apku04/sdr-doomsday-radio/hardware/README.md

# KiCad boards in this folder

Reference only. The owner changed the design on 2026-10-26: the front panel is hand-wired (no panel PCB) and the owner designs the HAT. These scripted KiCad boards (ERC/DRC clean) are kept for reference.
