apku04/sdr-doomsday-radio/hardware/hat/out/fab/sdr-hat-bottom.png

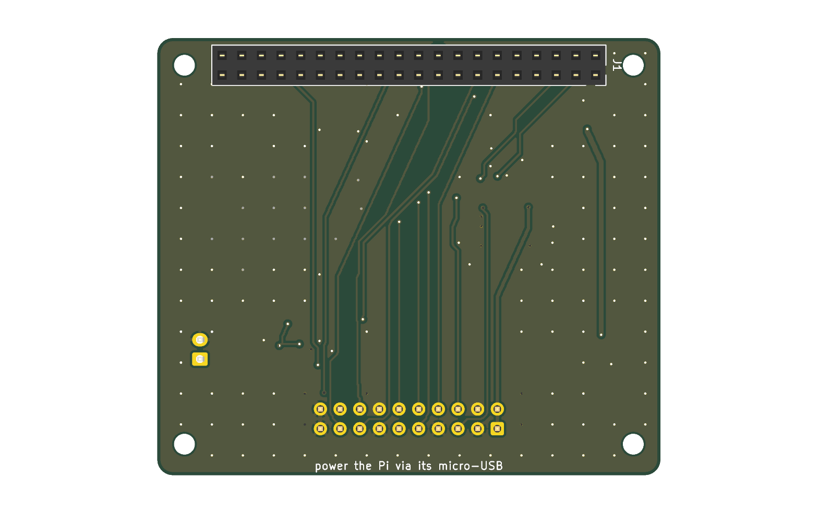
hardware/hat/out/fab/sdr-hat-bottom.png
