apku04/sdr-doomsday-radio/hardware/hat/out/fab/sdr-hat-top.png

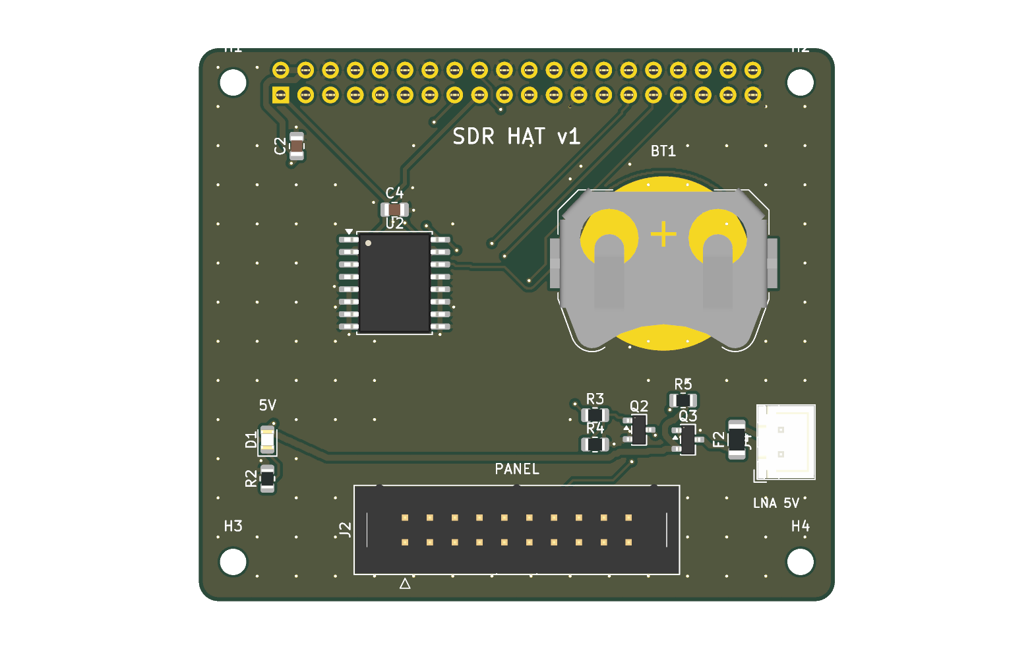
hardware/hat/out/fab/sdr-hat-top.png
