apku04/sdr-doomsday-radio/hardware/panel/out/fab/sdr-panel-bottom.png

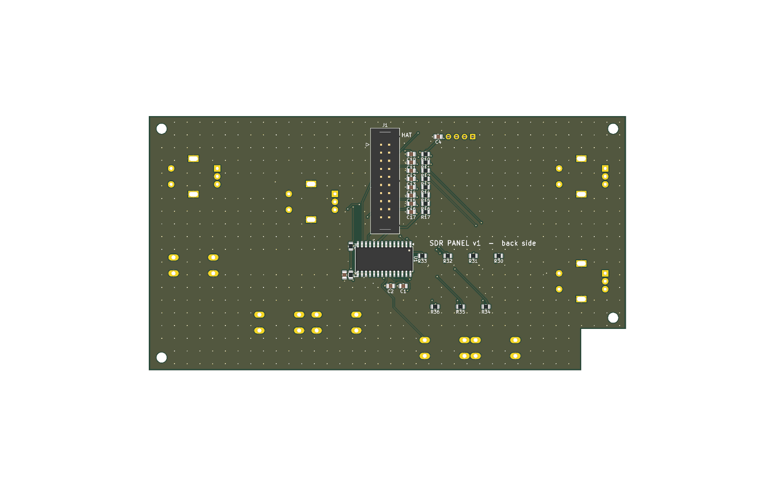
hardware/panel/out/fab/sdr-panel-bottom.png
