apku04/sdr-doomsday-radio/hardware/panel/out/fab/sdr-panel-top.png

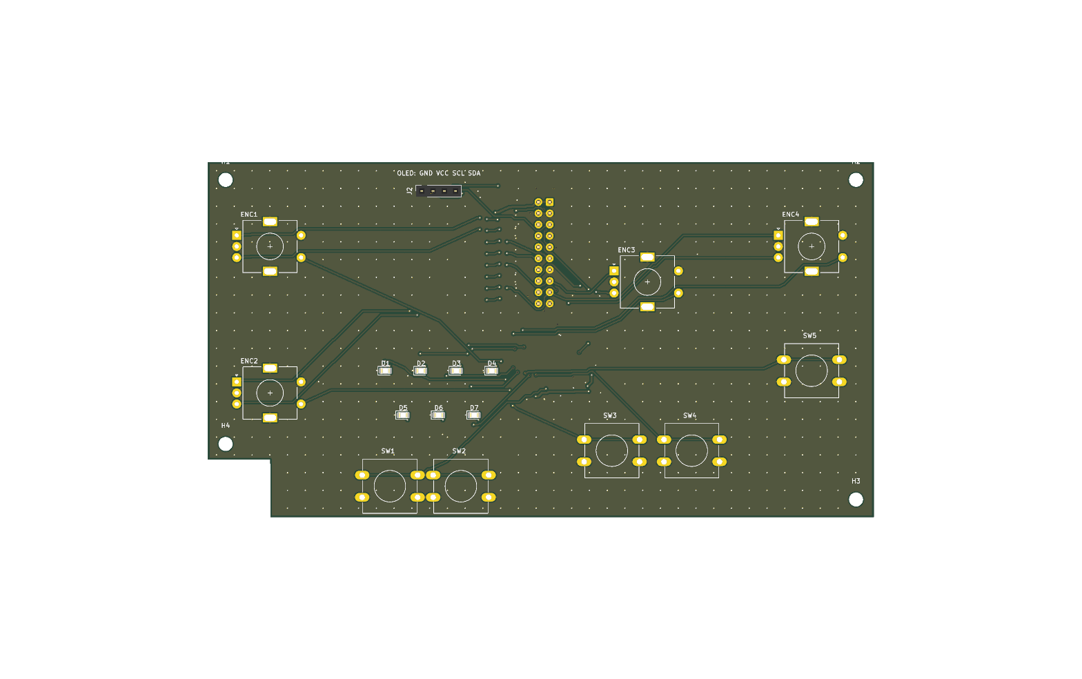
hardware/panel/out/fab/sdr-panel-top.png
