apku04/sdr-doomsday-radio/mechanical/out/preview_box_back.png

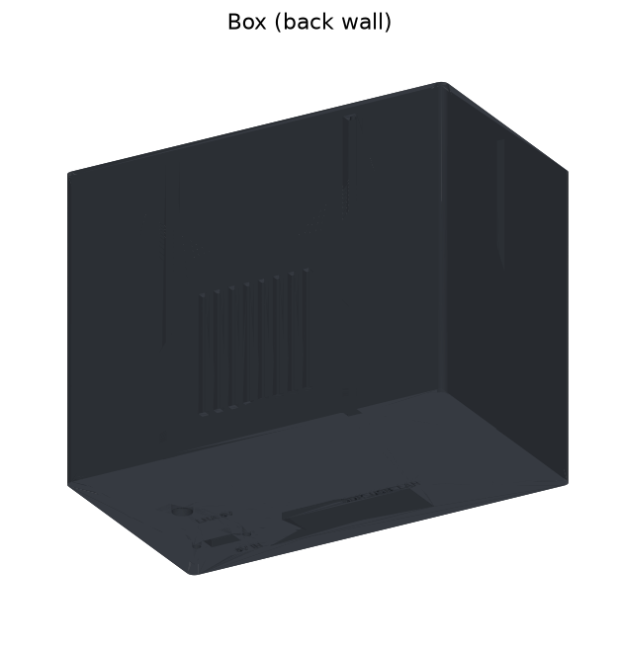
mechanical/out/preview_box_back.png
