apku04/sdr-doomsday-radio/mechanical/out/preview_box_front.png

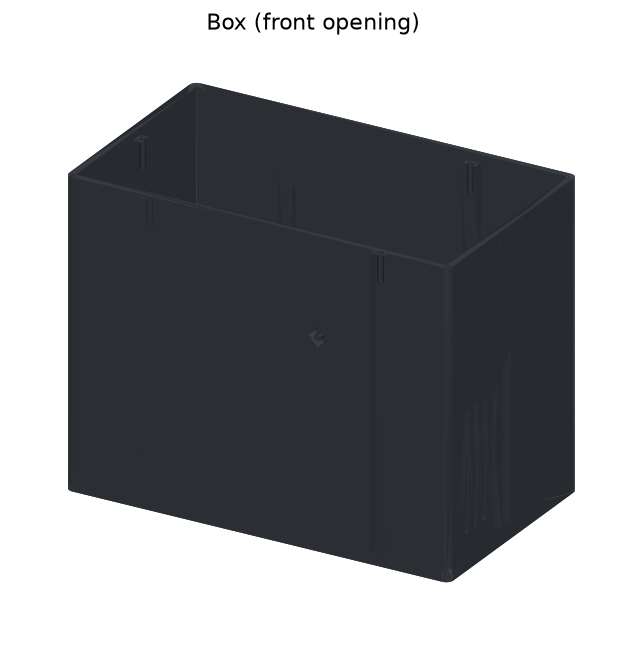
mechanical/out/preview_box_front.png
