apku04/sdr-doomsday-radio/mechanical/out/preview_lid.png

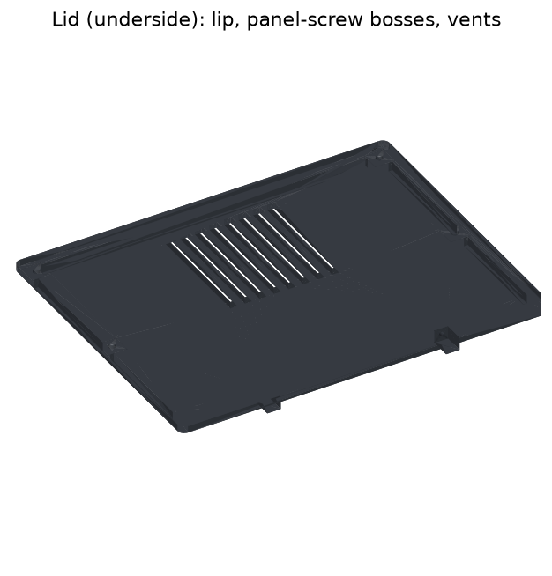
mechanical/out/preview_lid.png
