apku04/sdr-doomsday-radio/mechanical/out/preview_panel_back.png

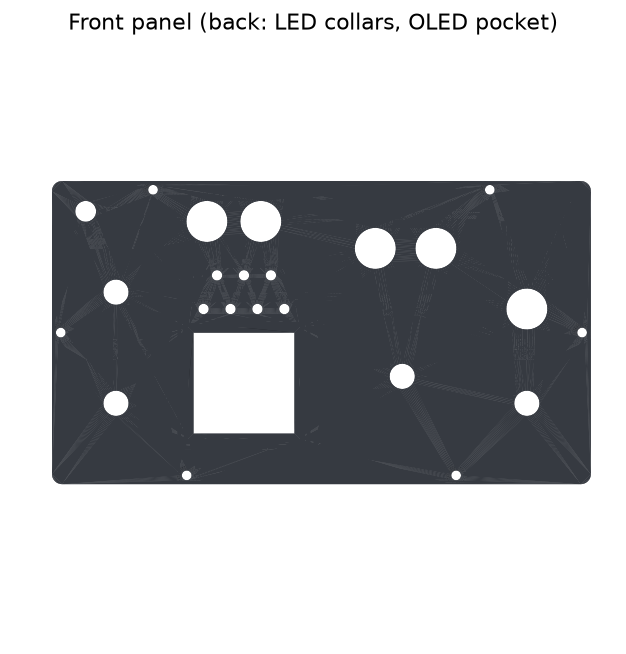
mechanical/out/preview_panel_back.png
