apku04/sdr-doomsday-radio/mechanical/out/preview_panel_front.png

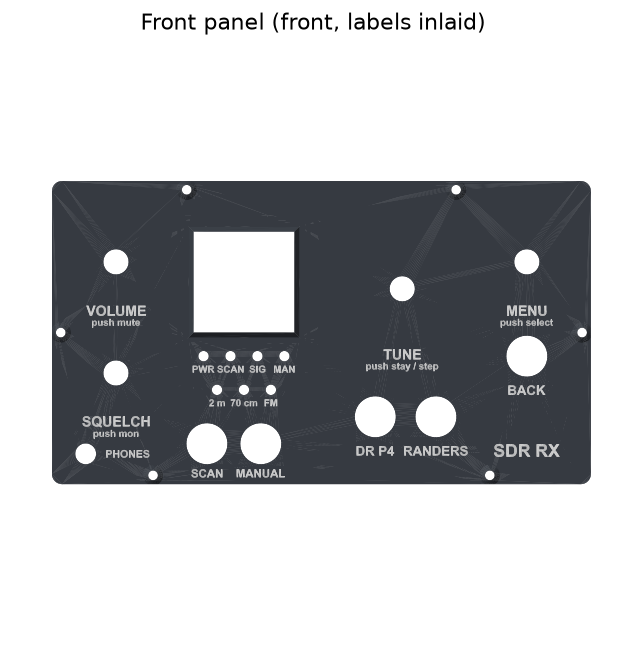
mechanical/out/preview_panel_front.png
