apku04/sdr-doomsday-radio/mechanical/out/preview_tray.png

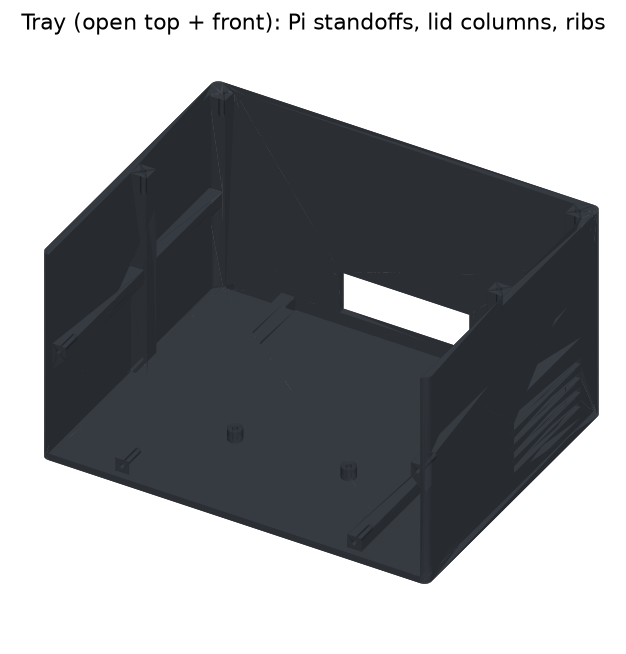
mechanical/out/preview_tray.png
