apku04/sdr-doomsday-radio/mechanical/out/preview_tray_back.png

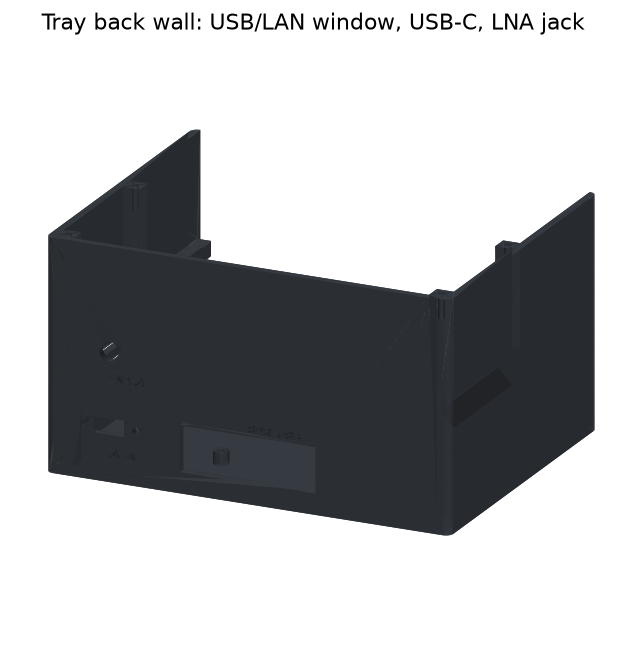
mechanical/out/preview_tray_back.png
