apku04/sdr-doomsday-radio/hardware/hat/out/fab/sdr-hat-bom.csv

Qty | References | Value | Footprint | LCSC | Note
1 | BT1 | CR2032 | BatteryHolder_Keystone_3034_1x20mm |  | Keystone 3034 SMD holder
1 | C2 | 10u | C_0805_2012Metric
1 | C4 | 100n | C_0805_2012Metric
1 | D1 | green 5V | LED_0805_2012Metric
1 | F2 | 0.5A hold | Fuse_1206_3216Metric |  | PTC 1206 0.5 A hold
1 | J1 | Pi GPIO socket | PinSocket_2x20_P2.54mm_Vertical |  | 2x20 female header, 8.5 mm (standard HAT height)
1 | J2 | PANEL | IDC-Header_2x10_P2.54mm_Vertical |  | 2x10 shrouded box header, keyed
1 | J4 | LNA 5V | JST_XH_B2B-XH-A_1x02_P2.50mm_Vertical |  | JST-XH 2-pin to back-panel LNA socket
1 | Q2 | 2N7002 | SOT-23
1 | Q3 | AO3401A | SOT-23
2 | R2 R3 | 1k | R_0805_2012Metric
1 | R4 | 100k | R_0805_2012Metric
1 | R5 | 10k | R_0805_2012Metric
1 | U2 | DS3231M+ | SOIC-16W_7.5x10.3mm_P1.27mm |  | I2C 0x68, MEMS RTC
