apku04/sdr-doomsday-radio/hardware/panel/out/fab/sdr-panel-bom.csv

Qty | References | Value | Footprint | LCSC | Note
2 | C1 C3 | 100n | C_0805_2012Metric
8 | C10 C11 C12 C13 C14 C15 C16 C17 | 10n | C_0805_2012Metric
2 | C2 C4 | 10u | C_0805_2012Metric
2 | D1 D3 | green 0805 | LED_0805_2012Metric
1 | D2 | amber 0805 | LED_0805_2012Metric
1 | D4 | blue 0805 | LED_0805_2012Metric
3 | D5 D6 D7 | white 0805 | LED_0805_2012Metric
4 | ENC1 ENC2 ENC3 ENC4 | EC11E (switch, 20 mm shaft) | RotaryEncoder_Alps_EC11E-Switch_Vertical_H20mm |  | EC11 vertical with push switch, M7 bushing
1 | J1 | TO HAT | IDC-Header_2x10_P2.54mm_Vertical |  | 2x10 shrouded box header
1 | J2 | OLED 1.5in SH1107 | PinSocket_1x04_P2.54mm_Vertical |  | check module pin order GND VCC SCL SDA before soldering
10 | R1 R10 R11 R12 R13 R14 R15 R16 R17 R2 | 10k | R_0805_2012Metric
3 | R30 R31 R32 | 1k | R_0805_2012Metric
4 | R33 R34 R35 R36 | 150R | R_0805_2012Metric
5 | SW1 SW2 SW3 SW4 SW5 | 12 mm tactile | SW_PUSH-12mm |  | 12x12 mm THT tactile, stem height to suit the panel
1 | U1 | MCP23017-E/SO | SOIC-28W_7.5x17.9mm_P1.27mm |  | I2C 0x20; GPA7/GPB7 used as outputs only
