apku04/sdr-doomsday-radio/mechanical/out/tray.step

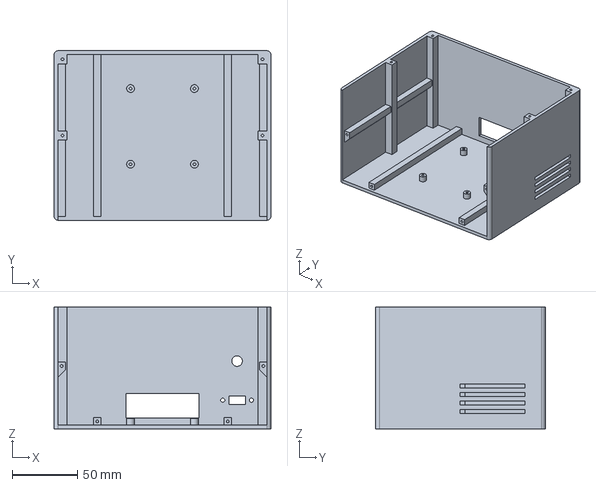
[picture p12: CAD file, 2026-10-26]
mechanical/out/tray.step
166.4 x 130.0 x 93.4 mm
