apku04/sdr-doomsday-radio/mechanical/out/lid.step

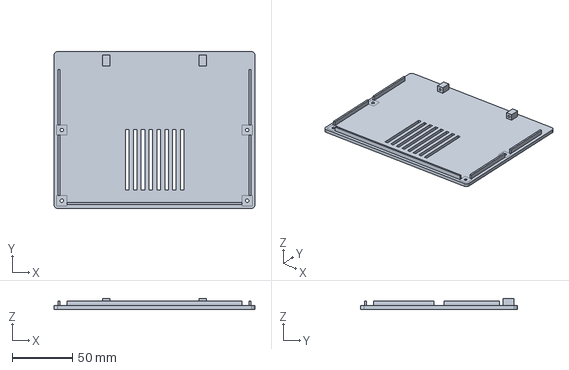
[picture p13: CAD file, 2026-10-26]
mechanical/out/lid.step
166.4 x 130.0 x 8.80 mm
