apku04/sdr-doomsday-radio/mechanical/out/panel.step

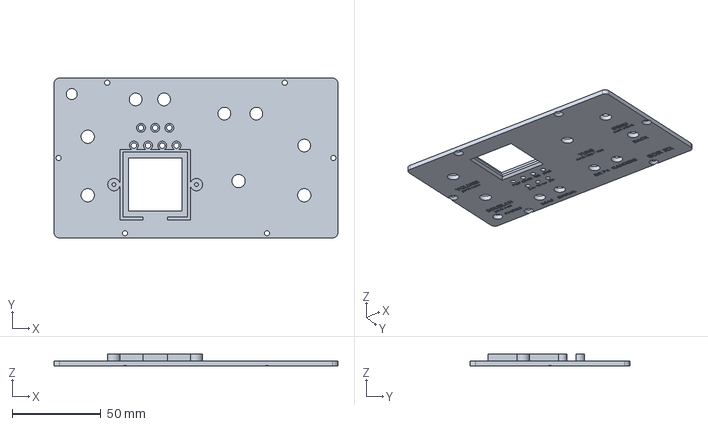
[picture p14: CAD file, 2026-10-26]
mechanical/out/panel.step
160.0 x 90.0 x 7.00 mm
