apku04/sdr-doomsday-radio/mechanical/out/panel_labels.stl

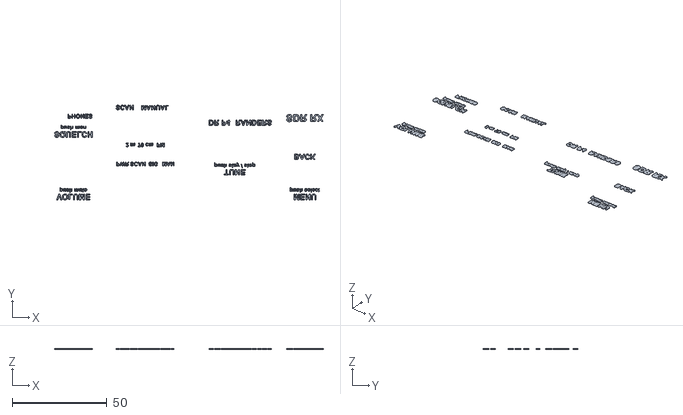
[picture p15: CAD file, 2026-10-26]
mechanical/out/panel_labels.stl
141.7 x 49.9 x 0.6
