apku04/sdr-doomsday-radio/mechanical/out/oled_clamp.stl

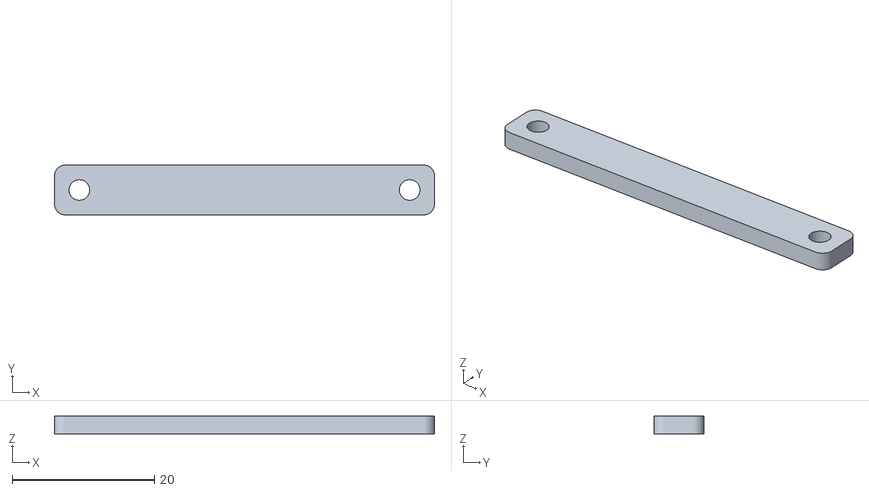
[picture p16: CAD file, 2026-10-26]
mechanical/out/oled_clamp.stl
53.5 x 7.00 x 2.50
