apku04/sdr-doomsday-radio/(list of files, cad)

Other CAD files:
mechanical/out/lid.stl
mechanical/out/panel.stl
mechanical/out/tray.stl
