apku04/sdr-doomsday-radio/hardware/hat/out/sch.pdf

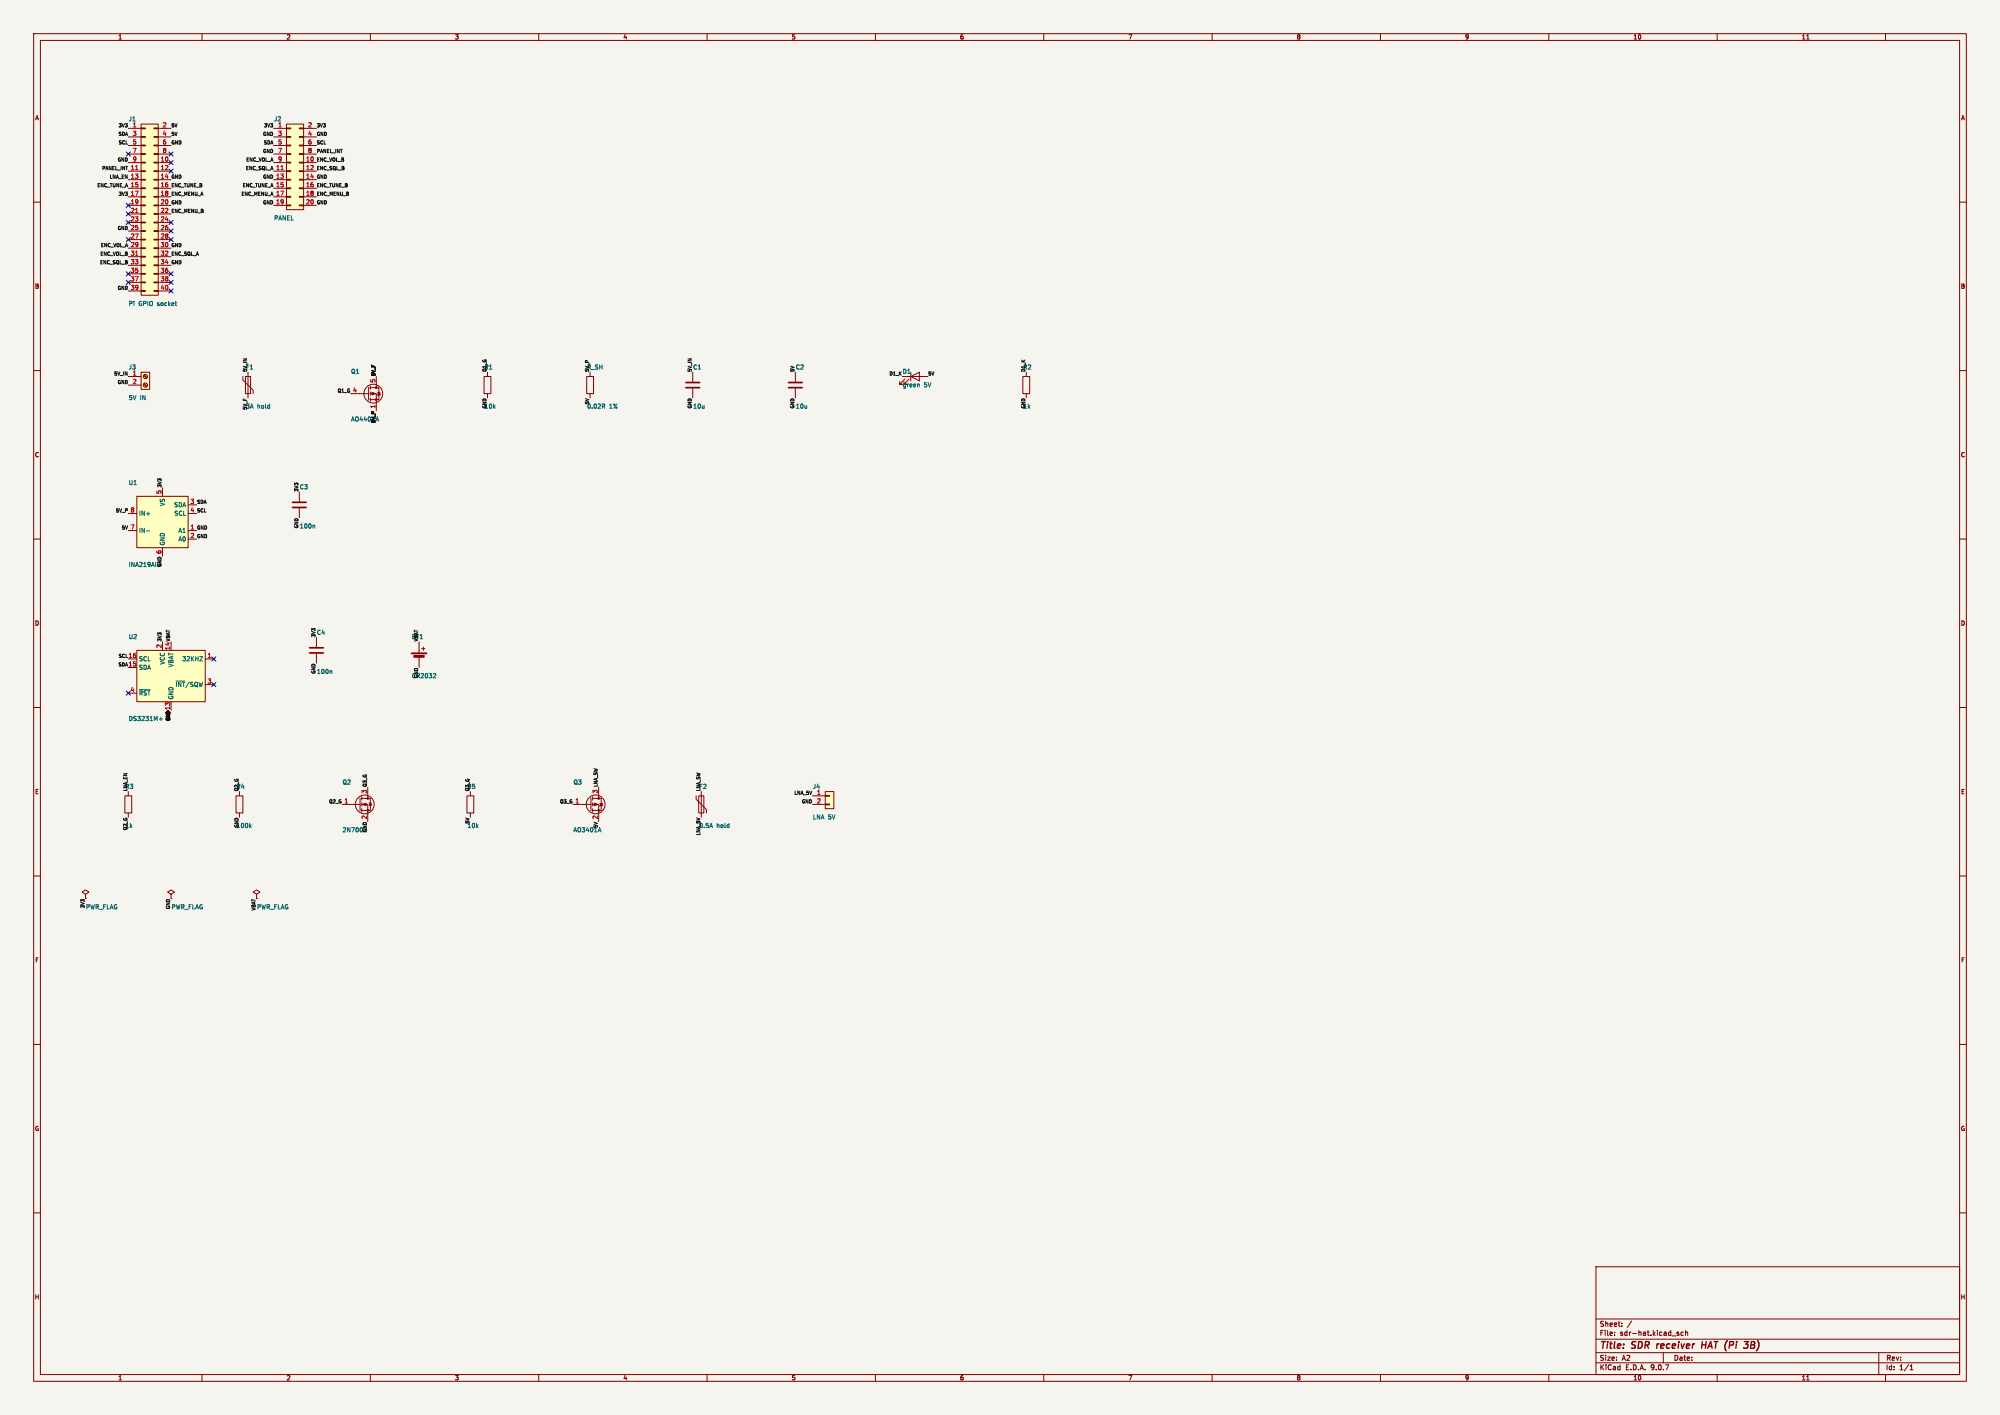
[picture p17: page 1]
