apku04/sdr-doomsday-radio/hardware/hat/out/fab/sdr-hat-schematic.pdf

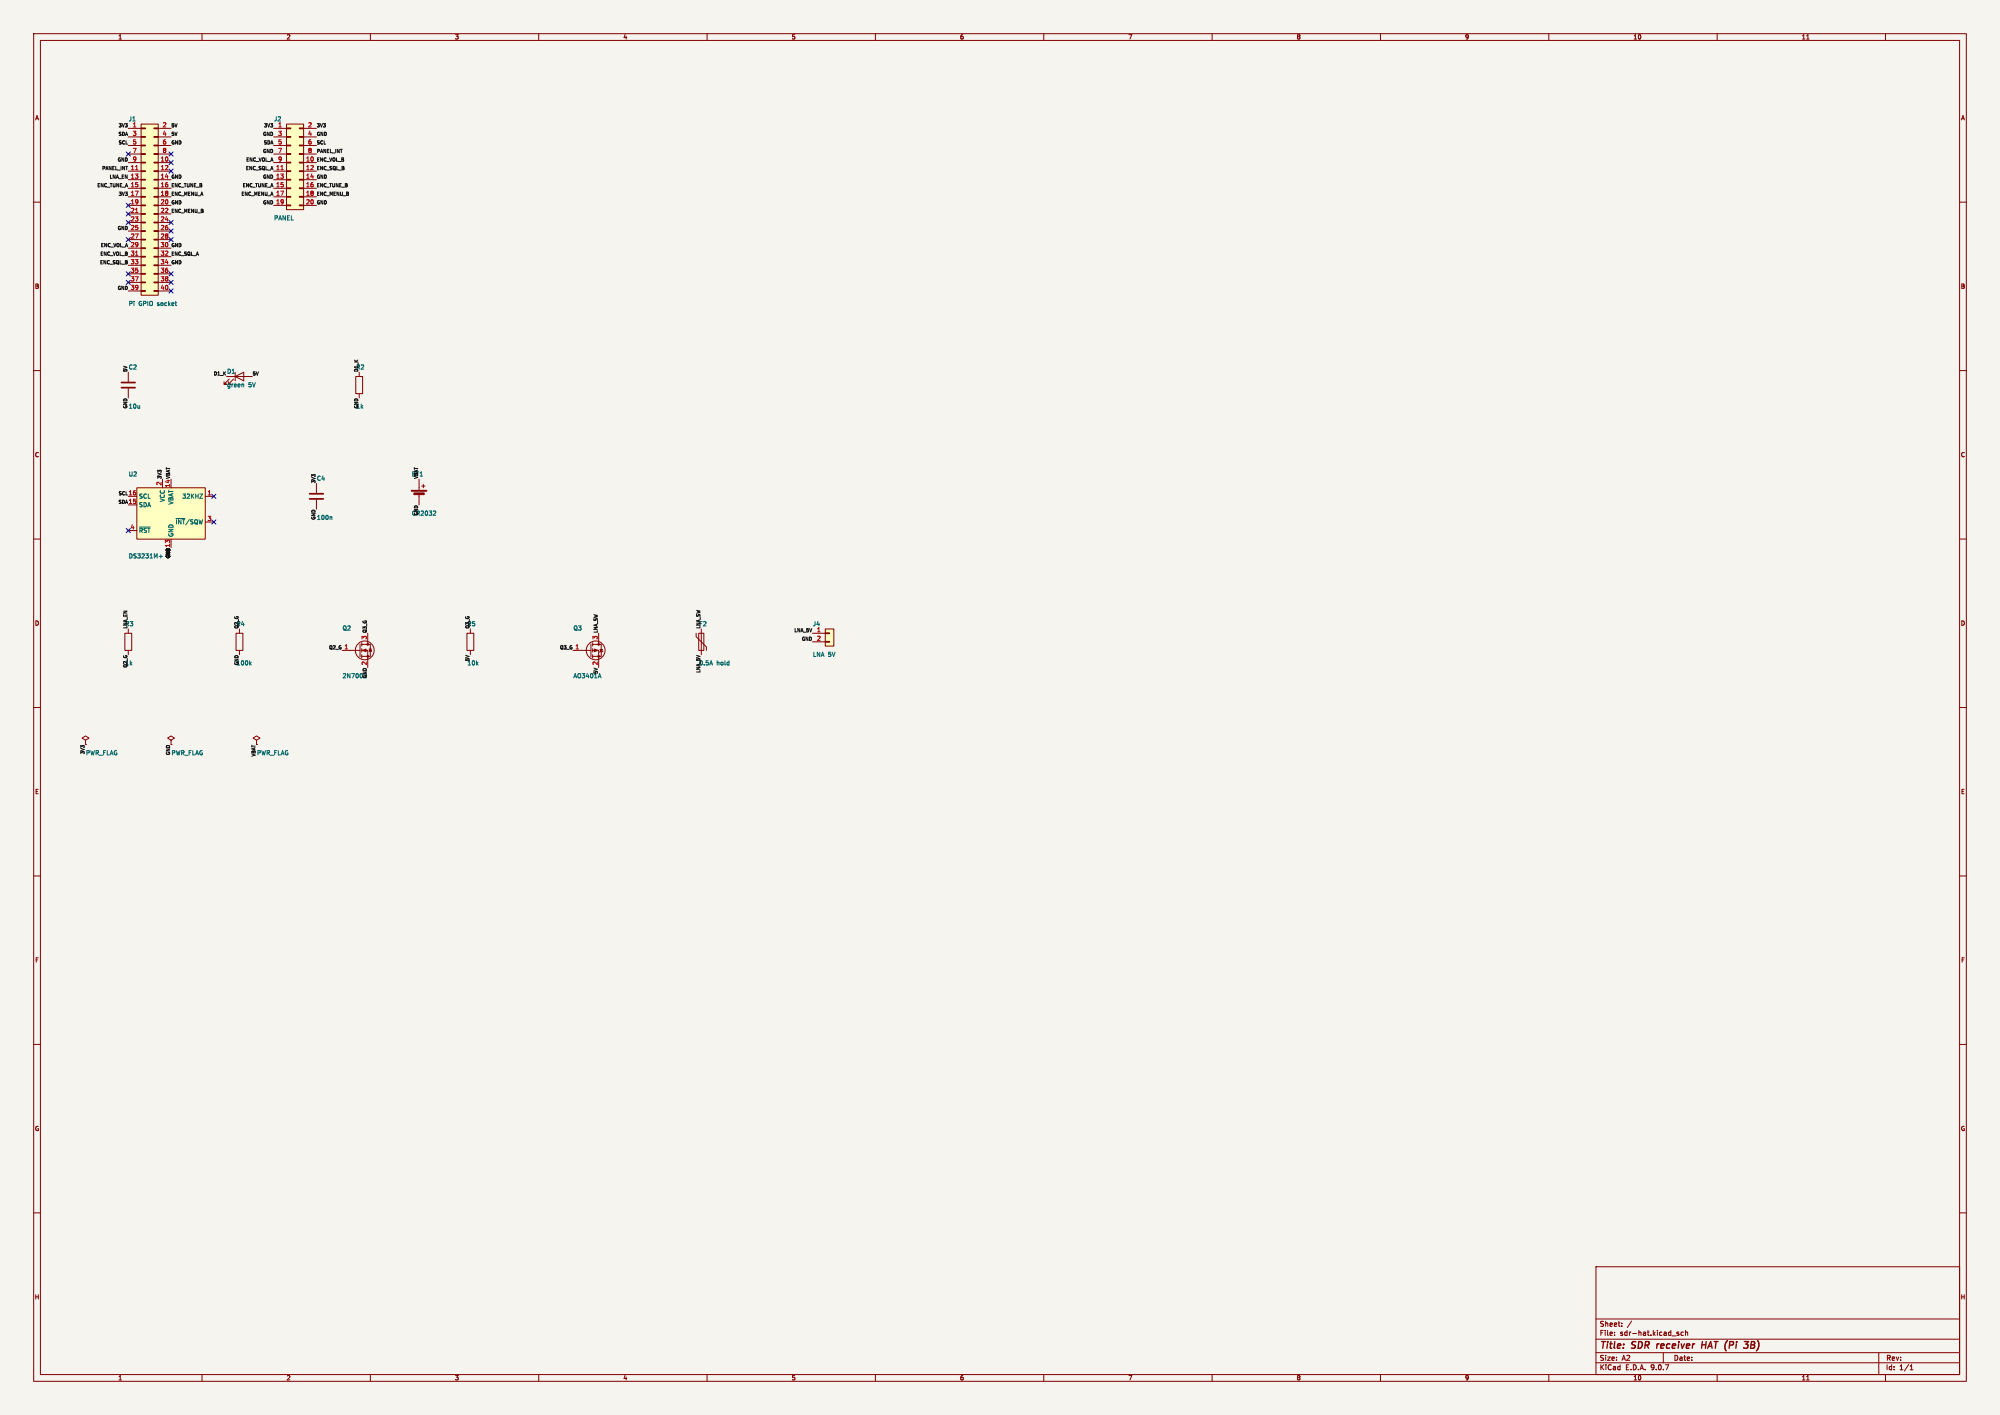
[picture p18: page 1]
