apku04/sdr-doomsday-radio/hardware/panel/out/fab/sdr-panel-schematic.pdf

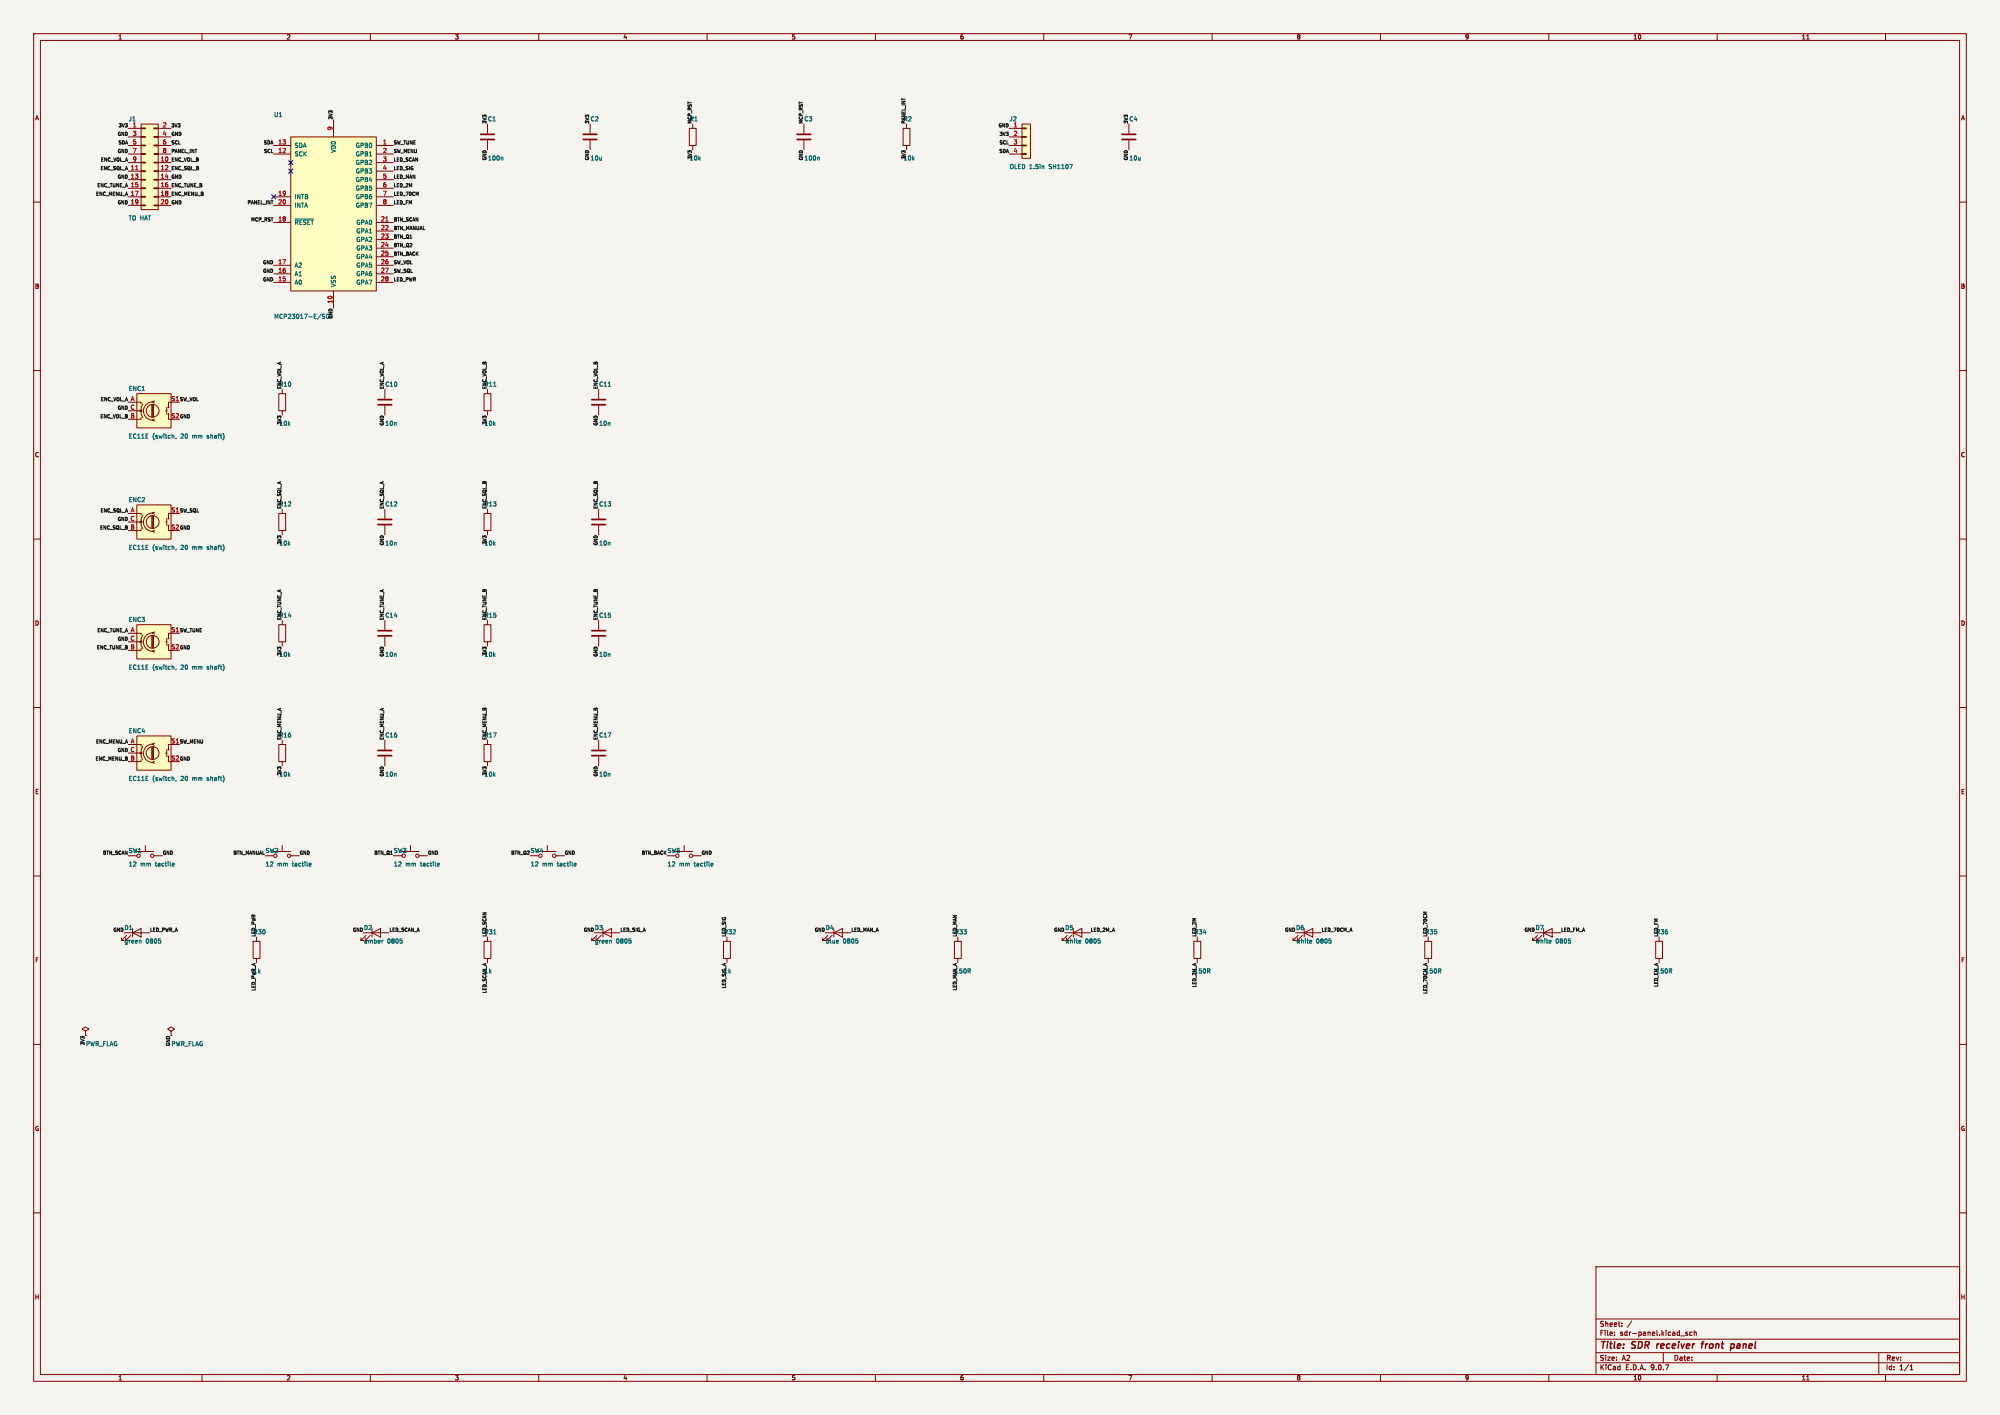
[picture p19: page 1]
