apku04/sdr-doomsday-radio/hardware/hat/out/sdr-hat.kicad_pcb

## KiCad design hardware/hat/out/sdr-hat.kicad_pcb (2026-10-26)

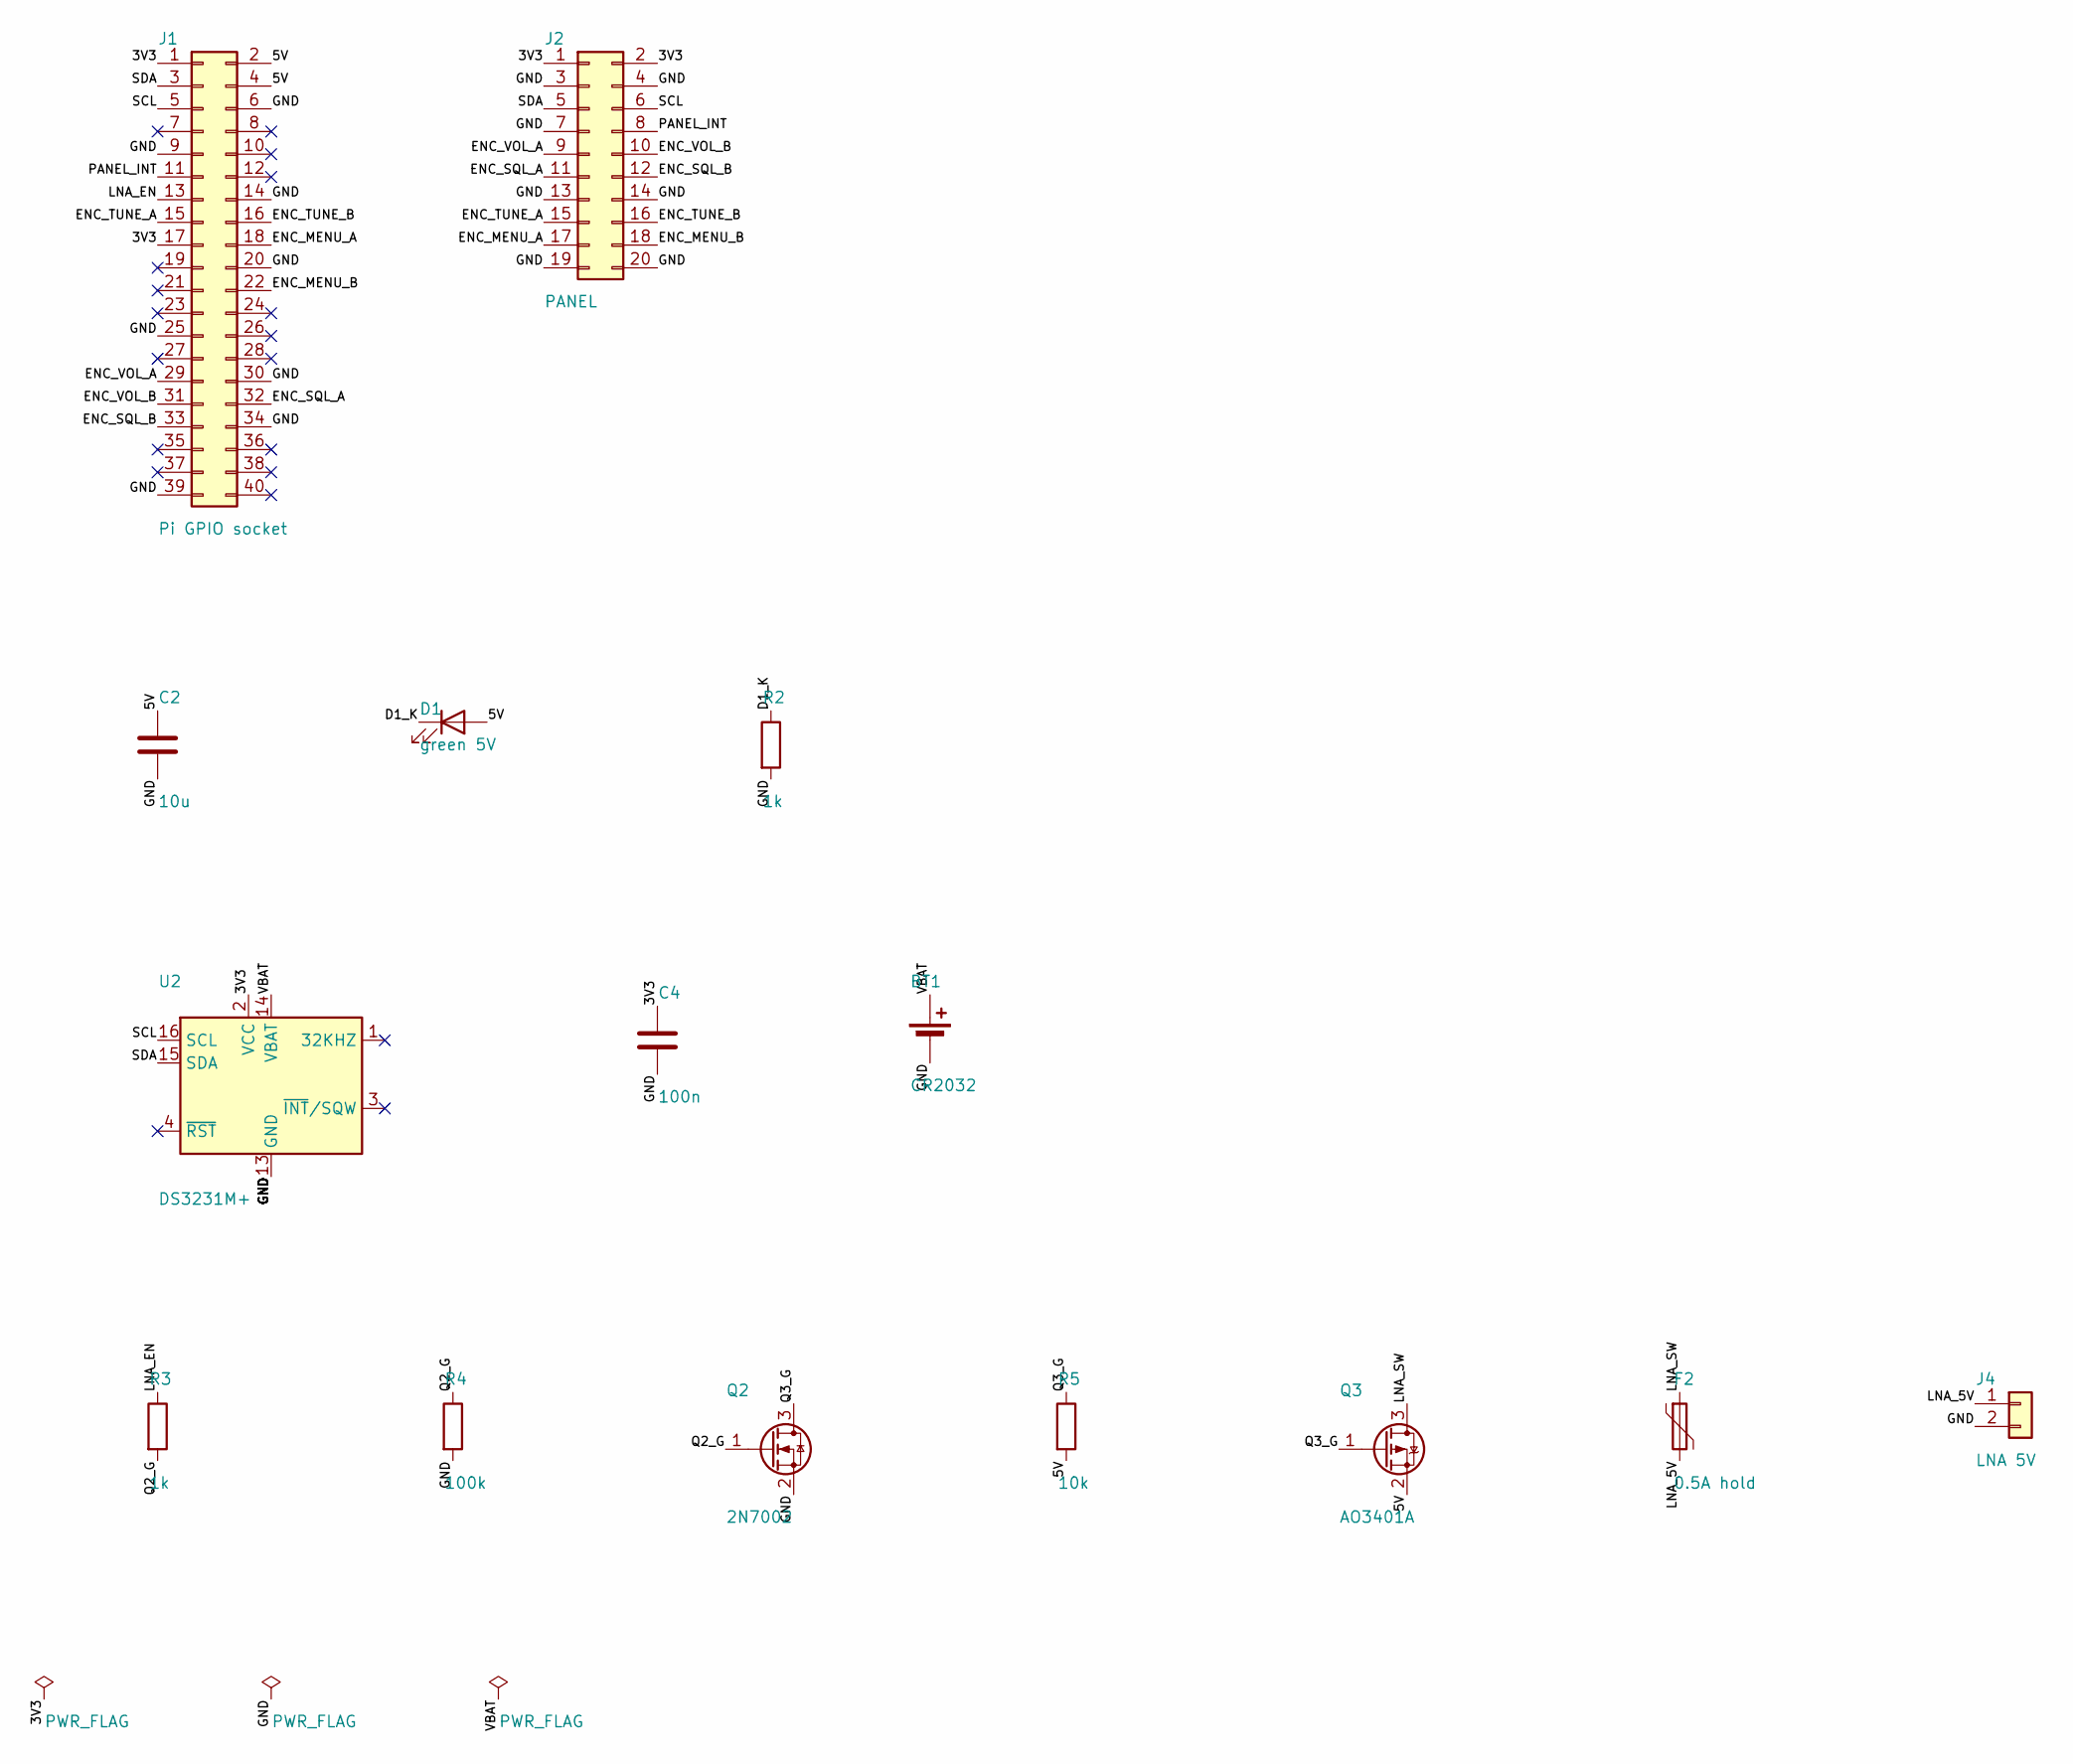
[picture p20: schematic sdr-hat.kicad_sch, SDR receiver HAT (Pi 3B)]

Parts:
BT1: CR2032; BatteryHolder_Keystone_3034_1x20mm
C2: 10u; C_0805_2012Metric
C4: 100n; C_0805_2012Metric
D1: green 5V; LED_0805_2012Metric
F2: 0.5A hold; Fuse_1206_3216Metric
J1: Pi GPIO socket; PinSocket_2x20_P2.54mm_Vertical
J2: PANEL; IDC-Header_2x10_P2.54mm_Vertical
J4: LNA 5V; JST_XH_B2B-XH-A_1x02_P2.50mm_Vertical
Q2: 2N7002; SOT-23
Q3: AO3401A; SOT-23
R2, R3: 1k; R_0805_2012Metric
R4: 100k; R_0805_2012Metric
R5: 10k; R_0805_2012Metric
U2: DS3231M+; SOIC-16W_7.5x10.3mm_P1.27mm

Connections:
3V3: C4.1, J1.1, J1.17, J2.1, J2.2, U2.2 (VCC)
5V: C2.1, D1.2 (A), J1.2, J1.4, Q3.2 (S), R5.2
D1_K: D1.1 (K), R2.1
ENC_MENU_A: J1.18, J2.17
ENC_MENU_B: J1.22, J2.18
ENC_SQL_A: J1.32, J2.11
ENC_SQL_B: J1.33, J2.12
ENC_TUNE_A: J1.15, J2.15
ENC_TUNE_B: J1.16, J2.16
ENC_VOL_A: J1.29, J2.9
ENC_VOL_B: J1.31, J2.10
GND: BT1.2 (-), C2.2, C4.2, J1.6, J1.9, J1.14, J1.20, J1.25, J1.30, J1.34, J1.39, J2.3, J2.4, J2.7, J2.13, J2.14, J2.19, J2.20, J4.2, Q2.2 (S), R2.2, R4.2, U2.5 (GND), U2.6 (GND), U2.7 (GND), U2.8 (GND), U2.9 (GND), U2.10 (GND), U2.11 (GND), U2.12 (GND), U2.13 (GND)
LNA_5V: F2.2, J4.1
LNA_EN: J1.13, R3.1
LNA_SW: F2.1, Q3.3 (D)
PANEL_INT: J1.11, J2.8
Q2_G: Q2.1 (G), R3.2, R4.1
Q3_G: Q2.3 (D), Q3.1 (G), R5.1
SCL: J1.5, J2.6, U2.16 (SCL)
SDA: J1.3, J2.5, U2.15 (SDA)
VBAT: BT1.1 (+), U2.14 (VBAT)

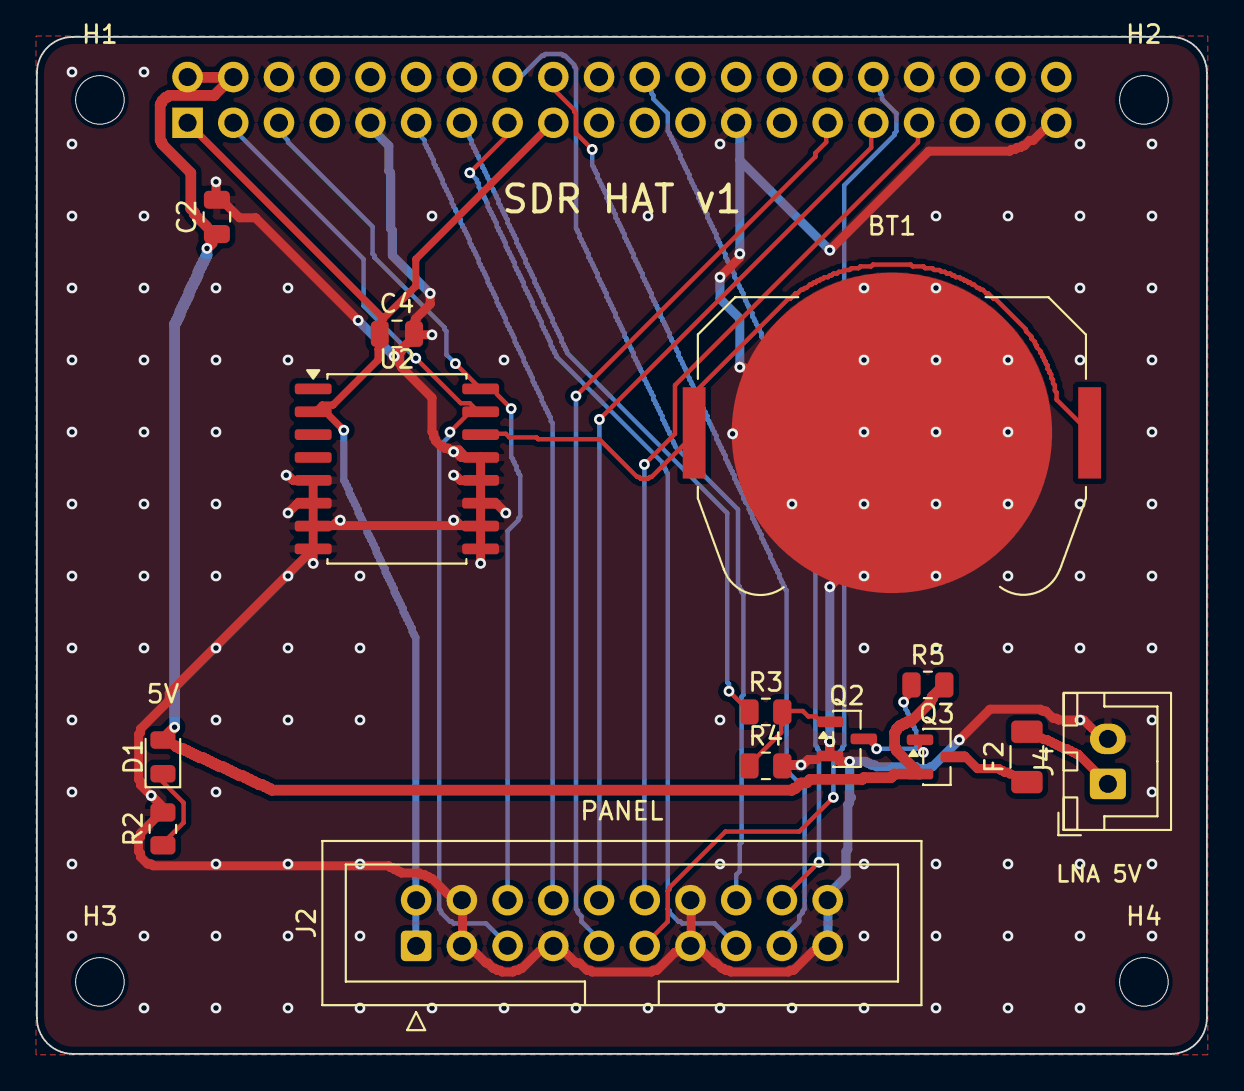
[picture p21: board sdr-hat.kicad_pcb from above]

Board: 2 copper layers, 65.0 x 56.5 mm, 19 parts (1 on the bottom side), 21 nets.

Other parts of the board:
H1, H2, H3, H4: MountingHole_2.7mm_M2.5
