apku04/sdr-doomsday-radio/hardware/panel/out/sdr-panel.kicad_pcb

## KiCad design hardware/panel/out/sdr-panel.kicad_pcb (2026-10-26)

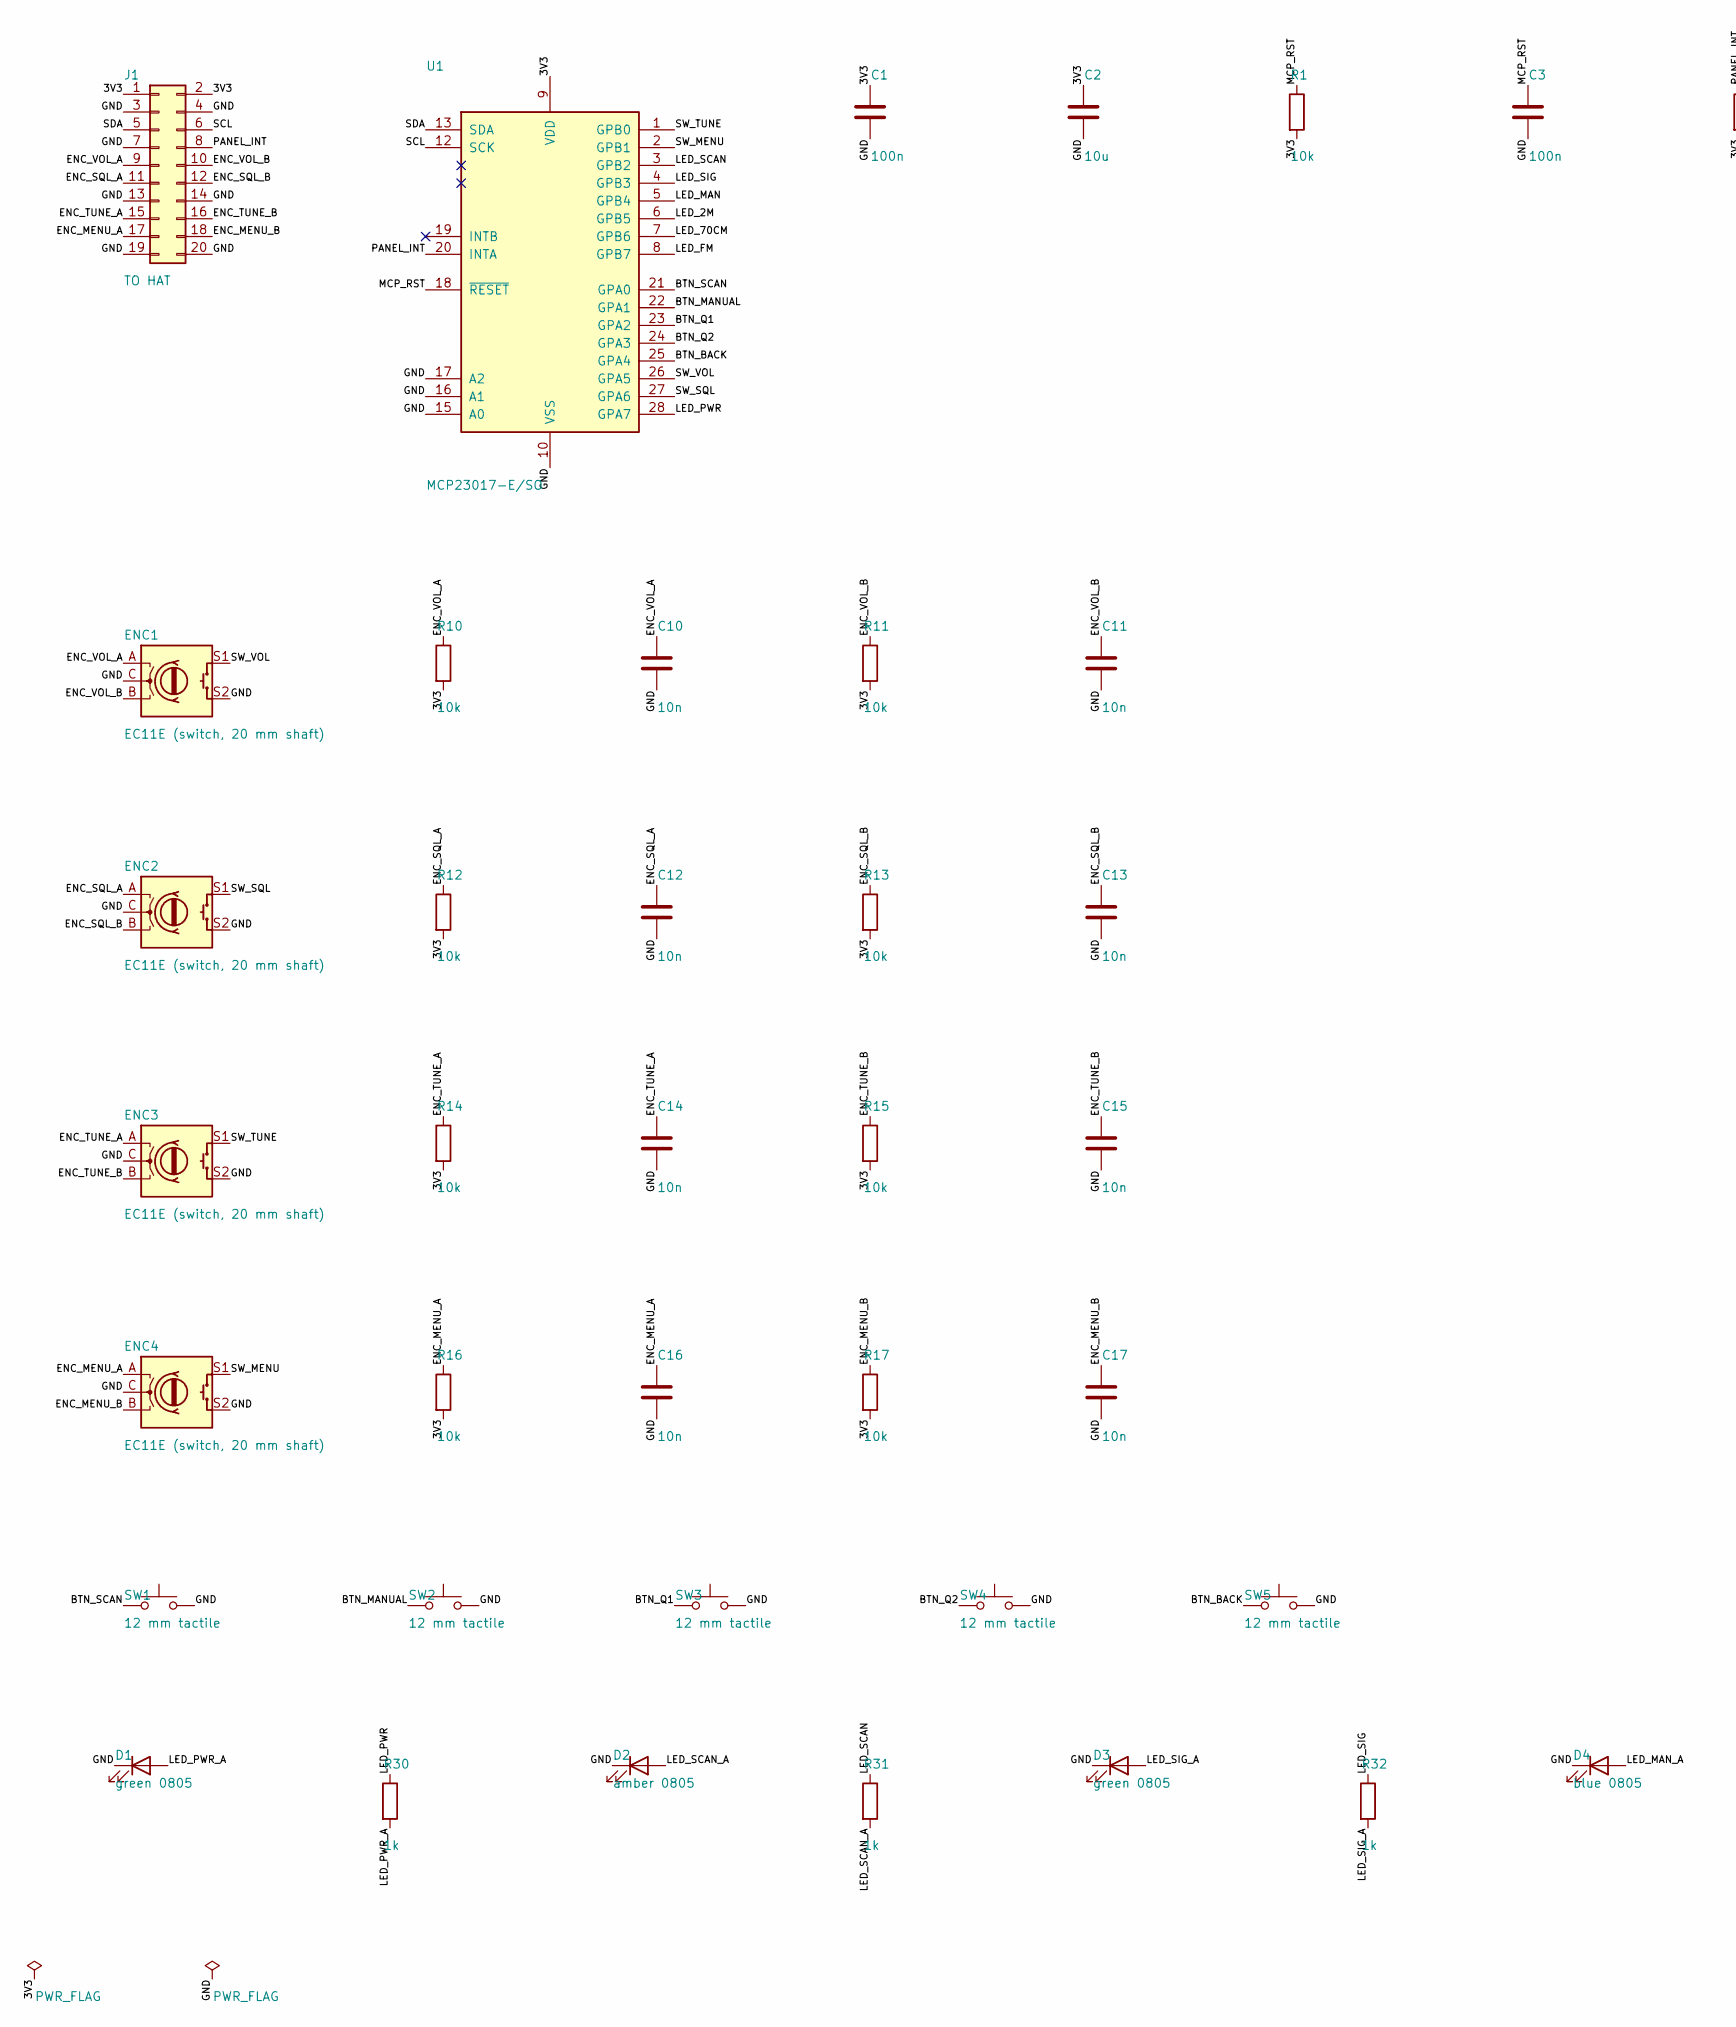
[picture p22: schematic sdr-panel.kicad_sch, SDR receiver front panel, part in row 1, column 1]

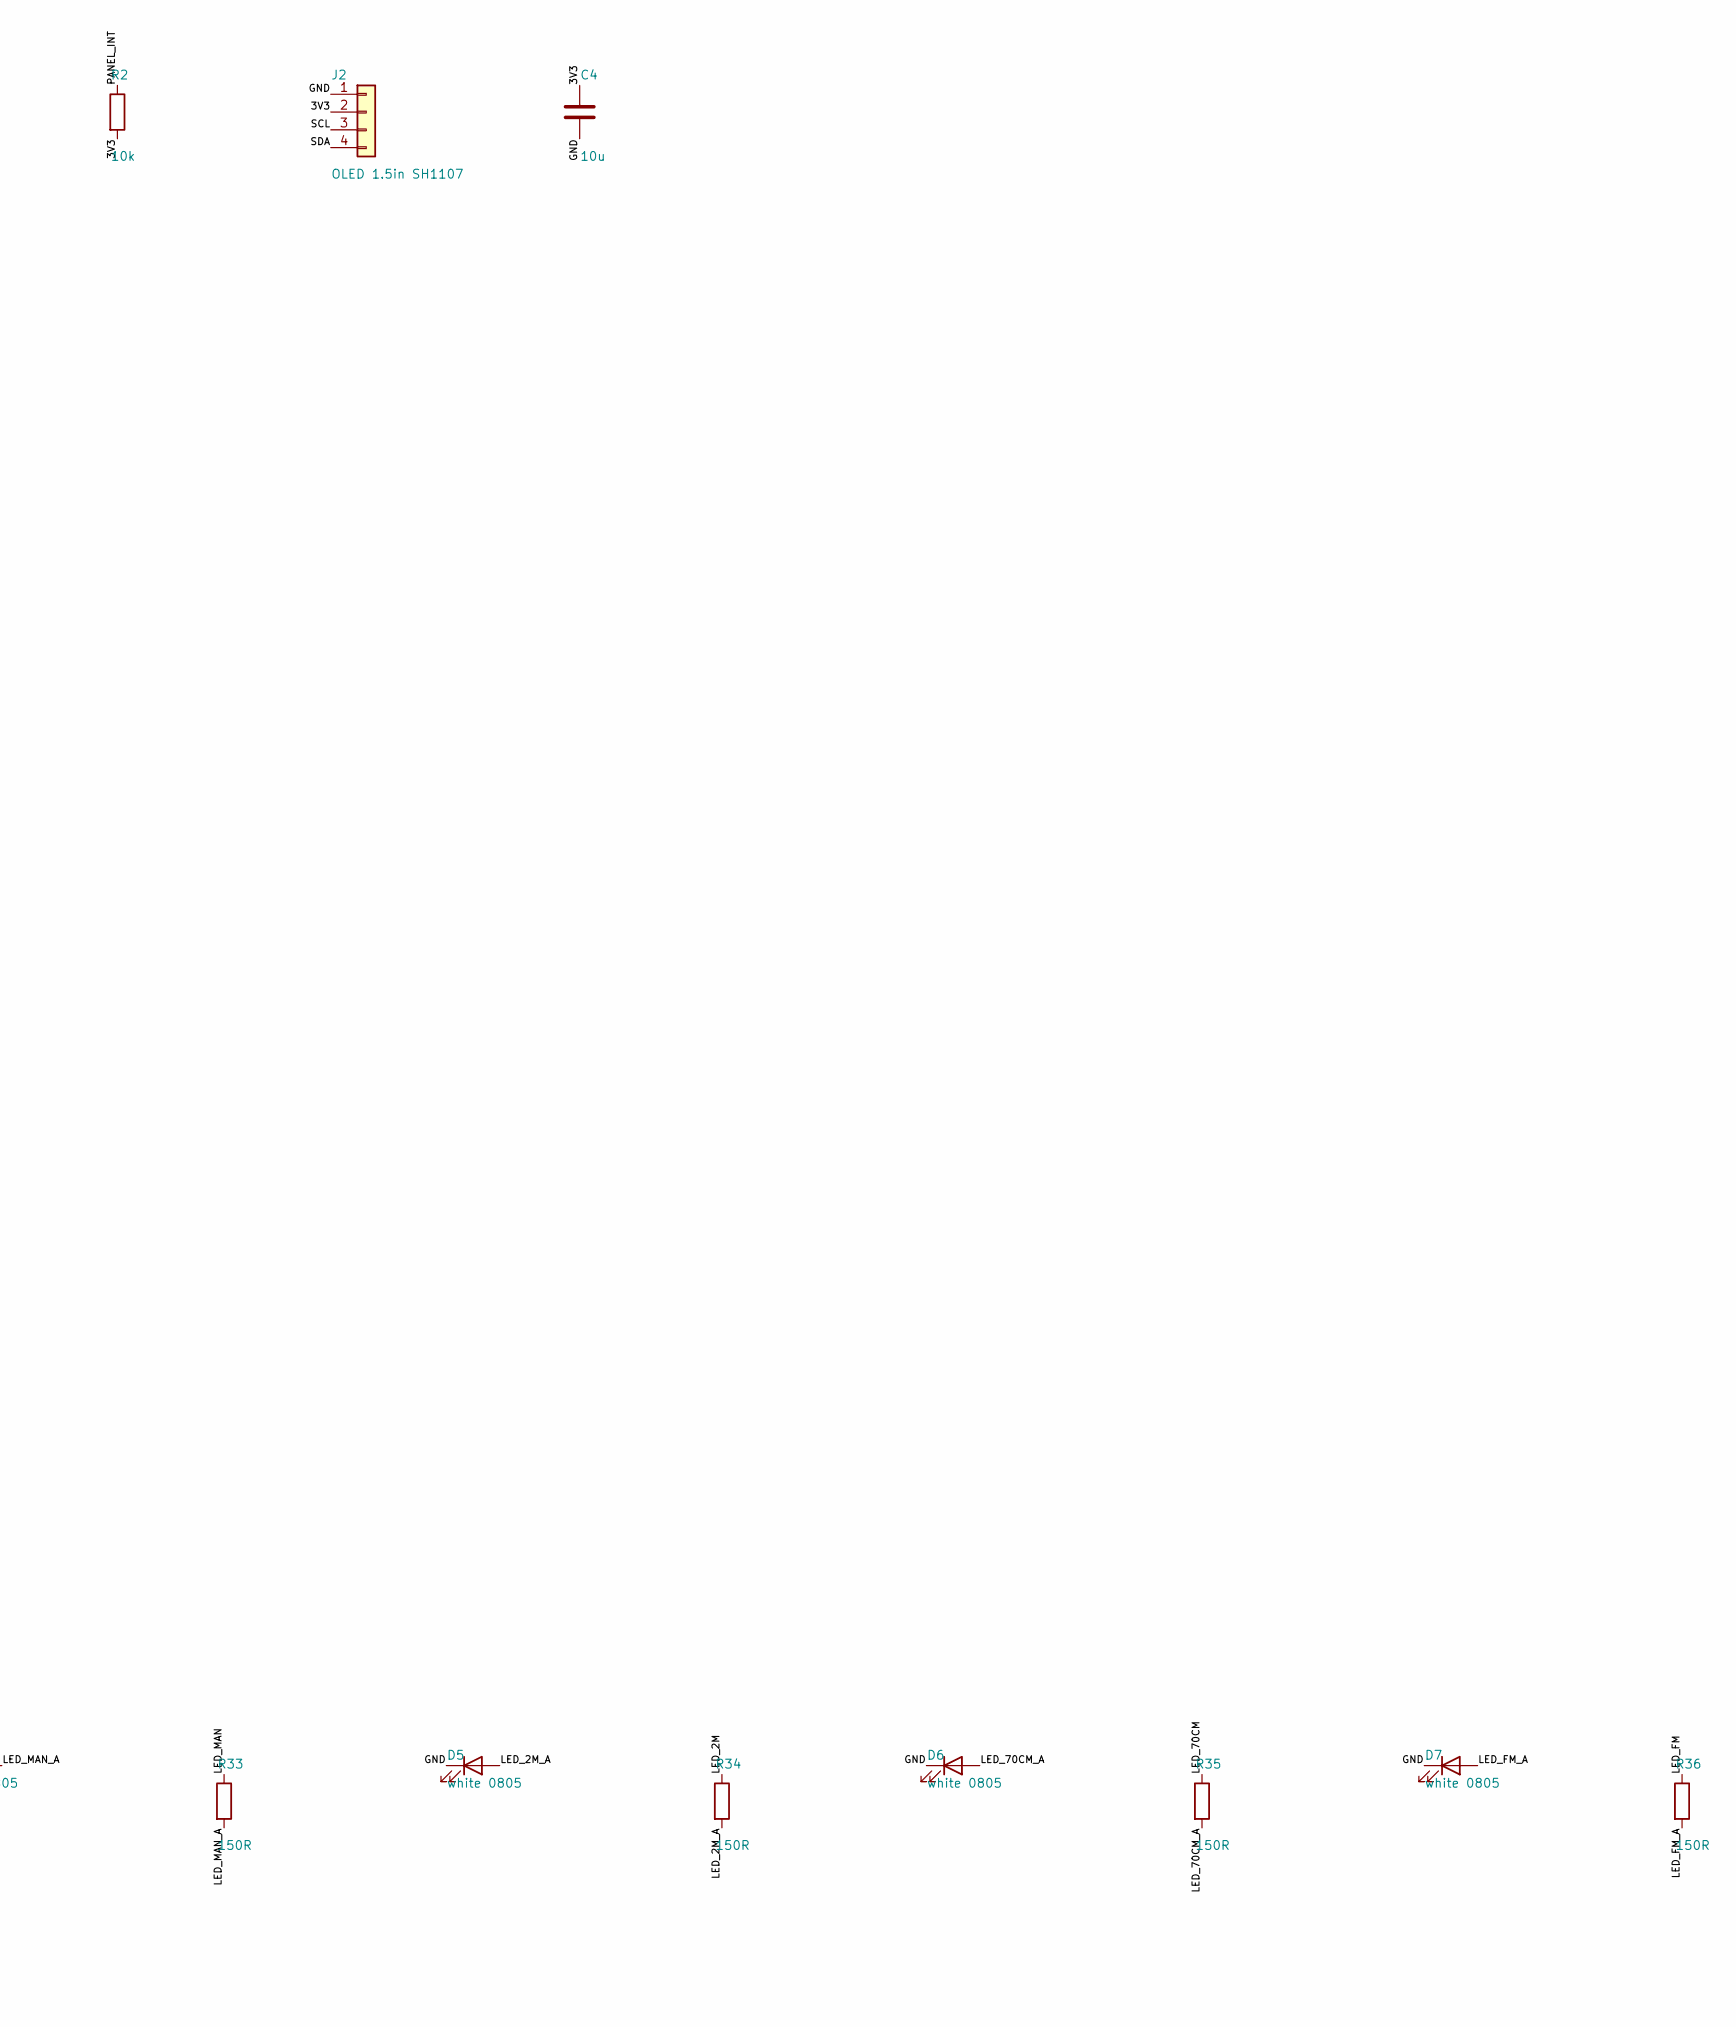
[picture p23: schematic sdr-panel.kicad_sch, SDR receiver front panel, part in row 1, column 2]

Parts:
C1, C3: 100n; C_0805_2012Metric
C2, C4: 10u; C_0805_2012Metric
C10, C11, C12, C13, C14, C15, C16, C17: 10n; C_0805_2012Metric
D1, D3: green 0805; LED_0805_2012Metric
D2: amber 0805; LED_0805_2012Metric
D4: blue 0805; LED_0805_2012Metric
D5, D6, D7: white 0805; LED_0805_2012Metric
ENC1, ENC2, ENC3, ENC4: EC11E (switch, 20 mm shaft); RotaryEncoder_Alps_EC11E-Switch_Vertical_H20mm
J1: TO HAT; IDC-Header_2x10_P2.54mm_Vertical
J2: OLED 1.5in SH1107; PinSocket_1x04_P2.54mm_Vertical
R1, R2, R10, R11, R12, R13, R14, R15, R16, R17: 10k; R_0805_2012Metric
R30, R31, R32: 1k; R_0805_2012Metric
R33, R34, R35, R36: 150R; R_0805_2012Metric
SW1, SW2, SW3, SW4, SW5: 12 mm tactile; SW_PUSH-12mm
U1: MCP23017-E/SO; SOIC-28W_7.5x17.9mm_P1.27mm

Connections:
3V3: C1.1, C2.1, C4.1, J1.1, J1.2, J2.2, R1.2, R2.2, R10.2, R11.2, R12.2, R13.2, R14.2, R15.2, R16.2, R17.2, U1.9 (VDD)
BTN_BACK: SW5.1, U1.25 (GPA4)
BTN_MANUAL: SW2.1, U1.22 (GPA1)
BTN_Q1: SW3.1, U1.23 (GPA2)
BTN_Q2: SW4.1, U1.24 (GPA3)
BTN_SCAN: SW1.1, U1.21 (GPA0)
ENC_MENU_A: C16.1, ENC4.A, J1.17, R16.1
ENC_MENU_B: C17.1, ENC4.B, J1.18, R17.1
ENC_SQL_A: C12.1, ENC2.A, J1.11, R12.1
ENC_SQL_B: C13.1, ENC2.B, J1.12, R13.1
ENC_TUNE_A: C14.1, ENC3.A, J1.15, R14.1
ENC_TUNE_B: C15.1, ENC3.B, J1.16, R15.1
ENC_VOL_A: C10.1, ENC1.A, J1.9, R10.1
ENC_VOL_B: C11.1, ENC1.B, J1.10, R11.1
GND: C1.2, C2.2, C3.2, C4.2, C10.2, C11.2, C12.2, C13.2, C14.2, C15.2, C16.2, C17.2, D1.1 (K), D2.1 (K), D3.1 (K), D4.1 (K), D5.1 (K), D6.1 (K), D7.1 (K), ENC1.C, ENC1.MP, ENC1.S2, ENC2.C, ENC2.MP, ENC2.S2, ENC3.C, ENC3.MP, ENC3.S2, ENC4.C, ENC4.MP, ENC4.S2, J1.3, J1.4, J1.7, J1.13, J1.14, J1.19, J1.20, J2.1, SW1.2, SW2.2, SW3.2, SW4.2, SW5.2, U1.10 (VSS), U1.15 (A0), U1.16 (A1), U1.17 (A2)
LED_2M: R34.1, U1.6 (GPB5)
LED_2M_A: D5.2 (A), R34.2
LED_70CM: R35.1, U1.7 (GPB6)
LED_70CM_A: D6.2 (A), R35.2
LED_FM: R36.1, U1.8 (GPB7)
LED_FM_A: D7.2 (A), R36.2
LED_MAN: R33.1, U1.5 (GPB4)
LED_MAN_A: D4.2 (A), R33.2
LED_PWR: R30.1, U1.28 (GPA7)
LED_PWR_A: D1.2 (A), R30.2
LED_SCAN: R31.1, U1.3 (GPB2)
LED_SCAN_A: D2.2 (A), R31.2
LED_SIG: R32.1, U1.4 (GPB3)
LED_SIG_A: D3.2 (A), R32.2
MCP_RST: C3.1, R1.1, U1.18 (~RESET)
PANEL_INT: J1.8, R2.1, U1.20 (INTA)
SCL: J1.6, J2.3, U1.12 (SCK)
SDA: J1.5, J2.4, U1.13 (SDA)
SW_MENU: ENC4.S1, U1.2 (GPB1)
SW_SQL: ENC2.S1, U1.27 (GPA6)
SW_TUNE: ENC3.S1, U1.1 (GPB0)
SW_VOL: ENC1.S1, U1.26 (GPA5)

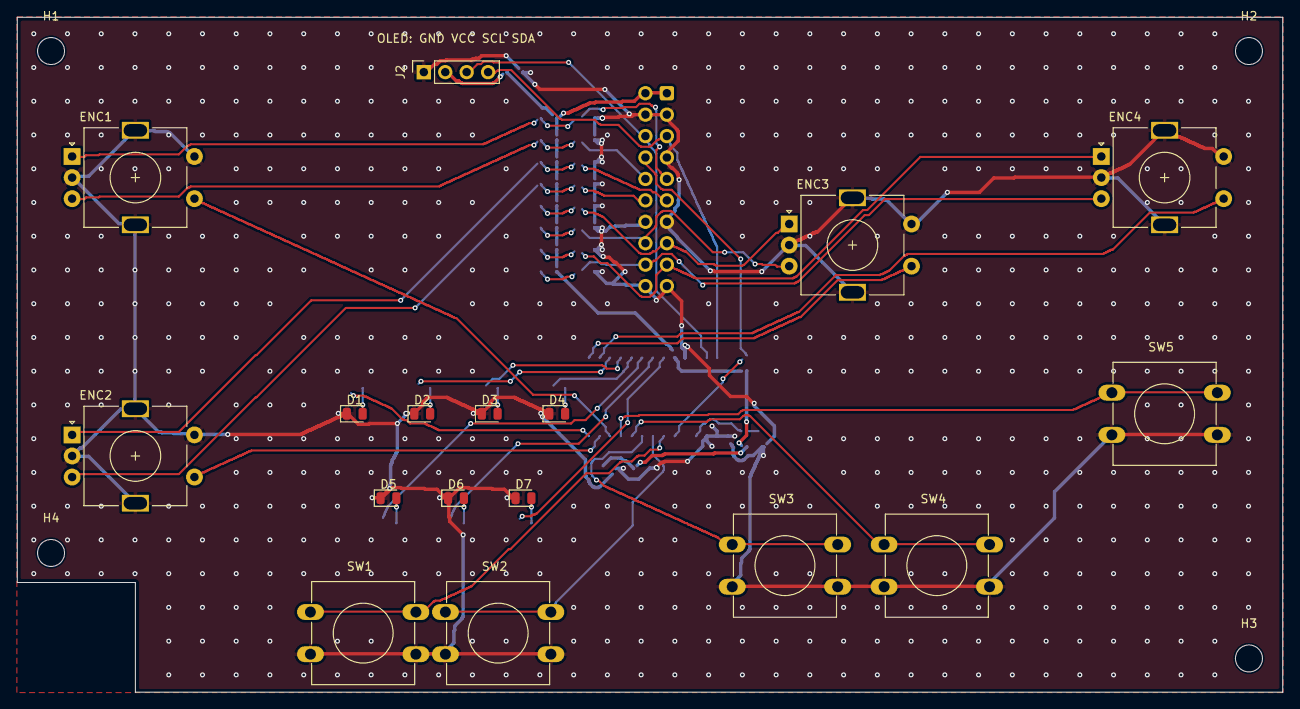
[picture p24: board sdr-panel.kicad_pcb from above]

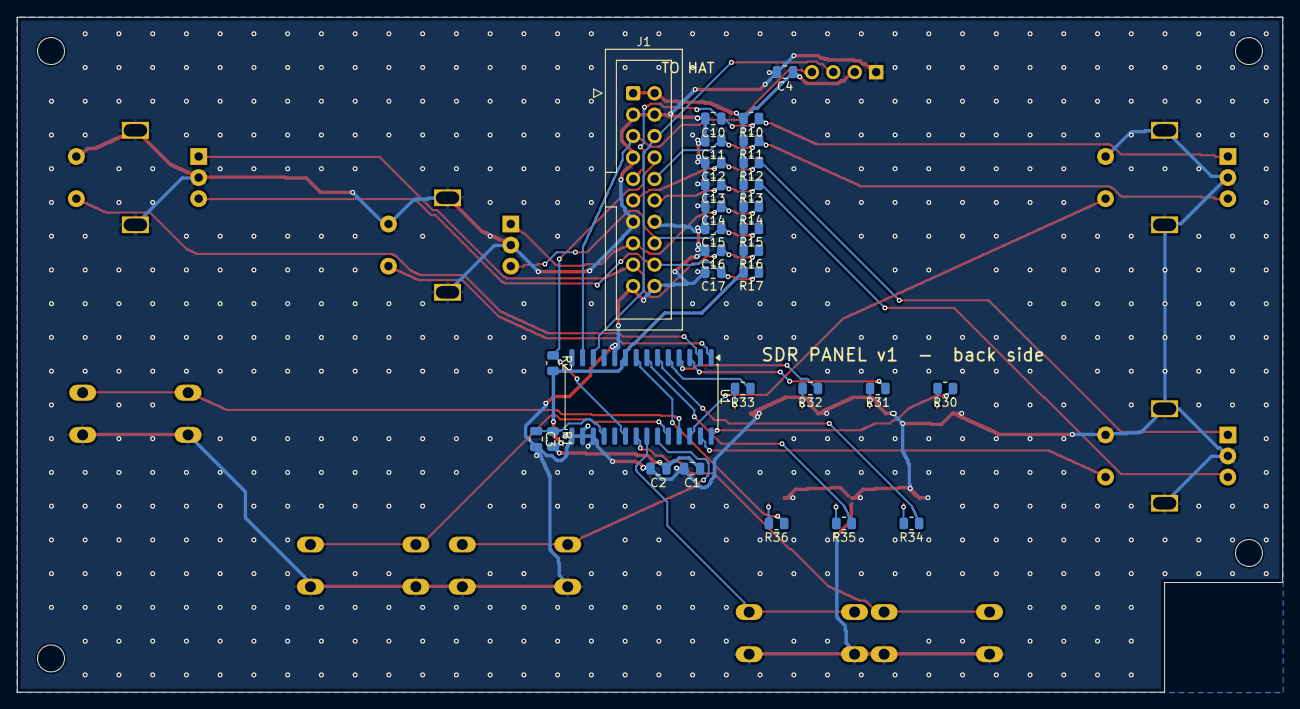
[picture p25: board sdr-panel.kicad_pcb from below]

Board: 2 copper layers, 150.0 x 80.0 mm, 52 parts (31 on the bottom side), 37 nets.

Other parts of the board:
H1, H2, H3, H4: MountingHole_3.2mm_M3
