apku04/sdr-doomsday-radio/software/sdr-receiver/app.py

#!/usr/bin/env python3
"""HTTP front end: static UI, JSON control API and the PCM audio stream."""
import atexit
import html
import logging
import queue
import signal
import struct
import sys
import time

from flask import Flask, Response, jsonify, request, send_from_directory
from werkzeug.serving import WSGIRequestHandler

from sdr.config import BASE_DIR, load_settings
from sdr.controller import ControlError, Controller
from sdr.heardlog import HeardLog
from sdr.recorder import Recorder
from sdr.presets import PresetError, PresetStore
from sdr.receiver import TooManyListeners

logging.basicConfig(level=logging.INFO, format="%(asctime)s %(levelname)s %(name)s: %(message)s")
log = logging.getLogger("app")


class _QuietPanelPolls(logging.Filter):
    """panel.py polls /api/state 10x a second from localhost: keep those out of the journal."""
    def filter(self, record):
        msg = record.getMessage()
        return not (msg.startswith("127.0.0.1 ") and "GET /api/state " in msg)


logging.getLogger("werkzeug").addFilter(_QuietPanelPolls())

settings = load_settings()
presets = PresetStore(settings)
ctl = Controller(settings, presets)
speaker = None
if settings.get("speaker", {}).get("enabled"):
    from sdr.speaker import Speaker
    speaker = Speaker(ctl, settings["speaker"])

_hl = settings.get("heard_log", {})
_rc = settings.get("recording", {})
recorder = (Recorder(BASE_DIR / _rc.get("dir", "data/rec"), _rc.get("keep_days", 30), _rc.get("max_mb", 1024))
            if _rc.get("enabled") else None)
heard = HeardLog(BASE_DIR / _hl.get("file", "data/heard.jsonl"), _hl.get("min_s", 1.0), _hl.get("max_entries", 500),
                 recorder)

app = Flask(__name__, static_folder=str(BASE_DIR / "static"), static_url_path="/static")
app.config["MAX_CONTENT_LENGTH"] = 4096

FRAME_MAGIC = b"PCM1"
GAP_S = 0.25  # pad this much silence when no audio arrives (squelch closed / stopped)


def bad(msg, code=400):
    return jsonify({"error": msg}), code


def body():
    data = request.get_json(silent=True)
    return data if isinstance(data, dict) else {}


@app.get("/")
def index():
    return send_from_directory(app.static_folder, "index.html")


@app.get("/api/config")
def api_config():
    return jsonify({
        "bands": {k: {kk: b[kk] for kk in ("label", "min_mhz", "max_mhz", "mode", "steps_khz")}
                  for k, b in settings["bands"].items()},
        "band_order": settings["band_order"],
        "modes": {k: m["label"] for k, m in settings["modes"].items()},
        "gains": ["auto"] + settings["receiver"]["gains"],
        "squelch_min_db": settings["squelch_min_db"],
        "squelch_max_db": settings["squelch_max_db"],
    })


@app.get("/api/state")
def api_state():
    st = ctl.state()
    st["speaker"] = speaker.info() if speaker else None
    st["heard"] = heard.summary(time.time())
    return jsonify(st)


@app.get("/api/heard")
def api_heard():
    try:
        n = max(1, min(500, int(request.args.get("n", 100))))
    except ValueError:
        return bad("n must be a number")
    return jsonify({"heard": heard.recent(n)})


@app.get("/heard/rec/<name>")
def heard_rec(name):
    p = recorder.path_of(name) if recorder else None
    if p is None:
        return bad("no such recording", 404)
    return send_from_directory(p.parent, p.name, mimetype="audio/wav", conditional=True)


@app.get("/heard")
def heard_page():
    """Plain table of the heard log with a player per recording (no JavaScript, no auto-refresh:
    a refresh would cut off playback)."""
    rows = []
    for e in heard.recent(500):
        t = time.strftime("%a %d %b %H:%M:%S", time.localtime(e["t"]))
        dur = f"{int(e['dur_s'] // 60)}:{int(e['dur_s'] % 60):02d}"
        live = " <b>(now)</b>" if e.get("live") else ""
        peak = "" if e["peak_db"] is None else f"{e['peak_db']:.0f}"
        audio = ""
        if e.get("audio") and recorder and recorder.path_of(e["audio"]):
            audio = f'<audio controls preload="none" src="/heard/rec/{e["audio"]}"></audio>'
        elif e.get("audio"):
            audio = '<span class="dim">deleted (older than the limit)</span>'
        rows.append(f"<tr><td>{t}{live}</td><td>{html.escape(e['name'])}</td>"
                    f"<td>{e['freq_mhz']:.4f}</td><td>{dur}</td><td>{peak}</td><td>{audio}</td></tr>")
    body = "".join(rows) or '<tr><td colspan="6">Nothing heard yet.</td></tr>'
    page = (
        '<!DOCTYPE html><html><head><meta charset="utf-8">'
        '<meta name="viewport" content="width=device-width,initial-scale=1"><title>RX-1 heard log</title>'
        "<style>body{font:15px system-ui,sans-serif;margin:1em}table{border-collapse:collapse}"
        "td,th{padding:.3em .7em;border-bottom:1px solid #ccc;text-align:left}.dim{color:#888}"
        "audio{height:32px;vertical-align:middle}</style></head><body>"
        '<h2>Heard log</h2><p><a href="/">back to the receiver</a> &middot; newest first &middot; '
        '<a href="/heard">refresh</a> &middot; recordings kept 30 days / 1 GB</p>'
        "<table><tr><th>When</th><th>Channel</th><th>MHz</th>"
        f"<th>Length</th><th>Peak dBFS</th><th>Recording</th></tr>{body}</table></body></html>")
    return Response(page, mimetype="text/html")


@app.post("/api/action")
def api_action():
    b = body()
    action = b.get("action")
    if not isinstance(action, str):
        return bad("missing action")
    value = b.get("value")
    if value is not None and not isinstance(value, (str, int, float)):
        return bad("value must be a string or number")
    try:
        ctl.do(action, value)
    except ControlError as e:
        return bad(str(e))
    return jsonify(ctl.state())


@app.get("/api/presets")
def api_presets():
    return jsonify({"presets": presets.all(), "problems": presets.problems})


@app.post("/api/presets")
def api_preset_add():
    b = body()
    band = b.get("band", ctl.band)
    if band not in settings["bands"]:
        return bad("unknown band")
    name = b.get("name")
    if name is not None and not isinstance(name, str):
        return bad("name must be text")
    try:
        p = presets.add(band, b.get("freq_mhz", ctl.freq_hz / 1e6), (name or "").strip() or None)
    except (PresetError, TypeError, ValueError) as e:
        return bad(str(e))
    ctl.msg(f"Preset added: {p['name']}")
    return jsonify(p)


@app.patch("/api/presets/<pid>")
def api_preset_update(pid):
    b = body()
    enabled = b.get("enabled")
    if enabled is not None and not isinstance(enabled, bool):
        return bad("enabled must be true/false")
    try:
        return jsonify(presets.update(pid, enabled=enabled, verification=b.get("verification")))
    except PresetError as e:
        return bad(str(e))


@app.delete("/api/presets/<pid>")
def api_preset_delete(pid):
    try:
        presets.remove(pid)
    except PresetError as e:
        return bad(str(e), 404)
    ctl.msg(f"Preset removed: {pid}")
    return jsonify({"ok": True})


@app.get("/audio")
def audio():
    """Endless stream of frames: 'PCM1' + u32 sample_rate + u32 byte_count + s16le mono PCM."""
    try:
        listener = ctl.rx.subscribe(settings["server"]["max_audio_clients"])
    except TooManyListeners:
        return bad("too many audio listeners", 503)

    def frames():
        try:
            while True:
                try:
                    rate, data = listener.q.get(timeout=GAP_S)
                except queue.Empty:
                    rate = ctl.rx.sample_rate
                    data = bytes(int(rate * GAP_S) * 2)
                yield struct.pack("<4sII", FRAME_MAGIC, rate, len(data)) + data
        finally:
            ctl.rx.unsubscribe(listener)

    return Response(frames(), mimetype="application/octet-stream",
                    headers={"Cache-Control": "no-store"})


def shutdown(*_):
    log.info("shutting down")
    ctl.shutdown()
    sys.exit(0)


if __name__ == "__main__":
    atexit.register(ctl.shutdown)
    signal.signal(signal.SIGTERM, shutdown)
    signal.signal(signal.SIGINT, shutdown)
    WSGIRequestHandler.timeout = 15  # drop stalled clients instead of tying up threads
    heard.watch(ctl)
    if speaker:
        speaker.start()
    if settings.get("autostart"):
        ctl.start()  # receiver errors are reported in the state, not raised
        if settings.get("autostart_scan"):
            try:
                ctl.scan_start()
            except ControlError as e:
                log.warning("autostart scan: %s", e)
    srv = settings["server"]
    log.info("listening on http://%s:%d/", srv["host"], srv["port"])
    app.run(host=srv["host"], port=int(srv["port"]), threaded=True, use_reloader=False)
