apku04/sdr-doomsday-radio/(commit log)

2026-10-26 hardware: circuit model, schematic writer, PCB builder, grid autorouter, DRC/ERC, fab export
2026-10-26 hardware: SDR HAT (RTC, INA219 power monitor, switched LNA 5V, panel ribbon); deterministic routing with retry
    [sdr-hat-B_Cu.gbl, sdr-hat-B_Mask.gbs, sdr-hat-B_Paste.gbp, sdr-hat-B_Silkscreen.gbo, sdr-hat-Edge_Cuts.gm1, sdr-hat-F_Cu.gtl, sdr-hat-F_Mask.gts, sdr-hat-F_Paste.gtp]
2026-10-26 hardware: front-panel board; HAT without power monitor (owner); router: GND vias first, pour nets last
    [sdr-hat-B_Cu.gbl, sdr-hat-B_Mask.gbs, sdr-hat-B_Paste.gbp, sdr-hat-B_Silkscreen.gbo, sdr-hat-Edge_Cuts.gm1, sdr-hat-F_Cu.gtl, sdr-hat-F_Mask.gts, sdr-hat-F_Paste.gtp]
2026-10-26 mechanical: printed front panel (hand-wired parts, 3 mm LEDs), label inlay, OLED clamp, box for P1S
    [box.step, box.stl, oled_clamp.stl, panel.step, panel.stl, panel_labels.stl]
2026-10-26 mechanical: 7 mm pushbutton holes (owner parts)
    [box.step, panel.step, panel.stl, panel_labels.stl]
2026-10-26 mechanical: box split into tray + lid so the Pi can be screwed in and the panel wired from above
    [box.step, box.stl, lid.step, lid.stl, panel.step, tray.step, tray.stl]
2026-11-02 sdr-receiver: front panel driver with OLED menu, autostart on boot
    panel.py runs as its own service (sdr-panel) and drives the hand-wired RX-1
    panel through the app's local HTTP API: 4 encoders, 9 buttons, 6 LEDs polled
    with lgpio group reads, SH1107 OLED home screen and menu (oled.py, ui.py).
    SCAN starts / skips a held channel, MANUAL stops. app.py autostarts the
    receiver and keeps panel state polls out of the journal.
    [app.py, oled.py, panel.py, ui.py]
2026-11-02 sdr-receiver: play the radio on the Pi itself (USB speaker, 3.5 mm jack fallback)
    sdr/speaker.py feeds receiver audio into aplay with the web UI's volume curve
    (VOL knob / mute apply), writes silence while the squelch is closed, and moves
    between the USB speaker and the headphone jack as they appear and disappear.
2026-11-02 sdr-receiver: 70 cm squelch default -52 -> -46 dBFS (measured noise -54..-50 on all 70 cm presets)
2026-11-02 sdr-receiver: passive heard log, scan at boot, DR P4 button
    sdr/heardlog.py logs every squelch opening >= 1 s on analogue channels
    (time, channel, length, peak) to data/heard.jsonl; shown in the OLED menu
    (HEARD, push to tune), on the home screen (LAST hh:mm) and at /heard.
    The receiver now starts on 2 m and scans at boot instead of FM broadcast.
    DR P4 button -> preset 95.9 MHz (not receivable here; station still to find).
